nanofury/NanoFury/NF1/kicad/NF1-MCP-V01/NF1-MCP2210-v1.sch

## KiCad design NF1/kicad/NF1-MCP-V01/NF1-MCP2210-v1.sch (2013-09-19, an earlier design)

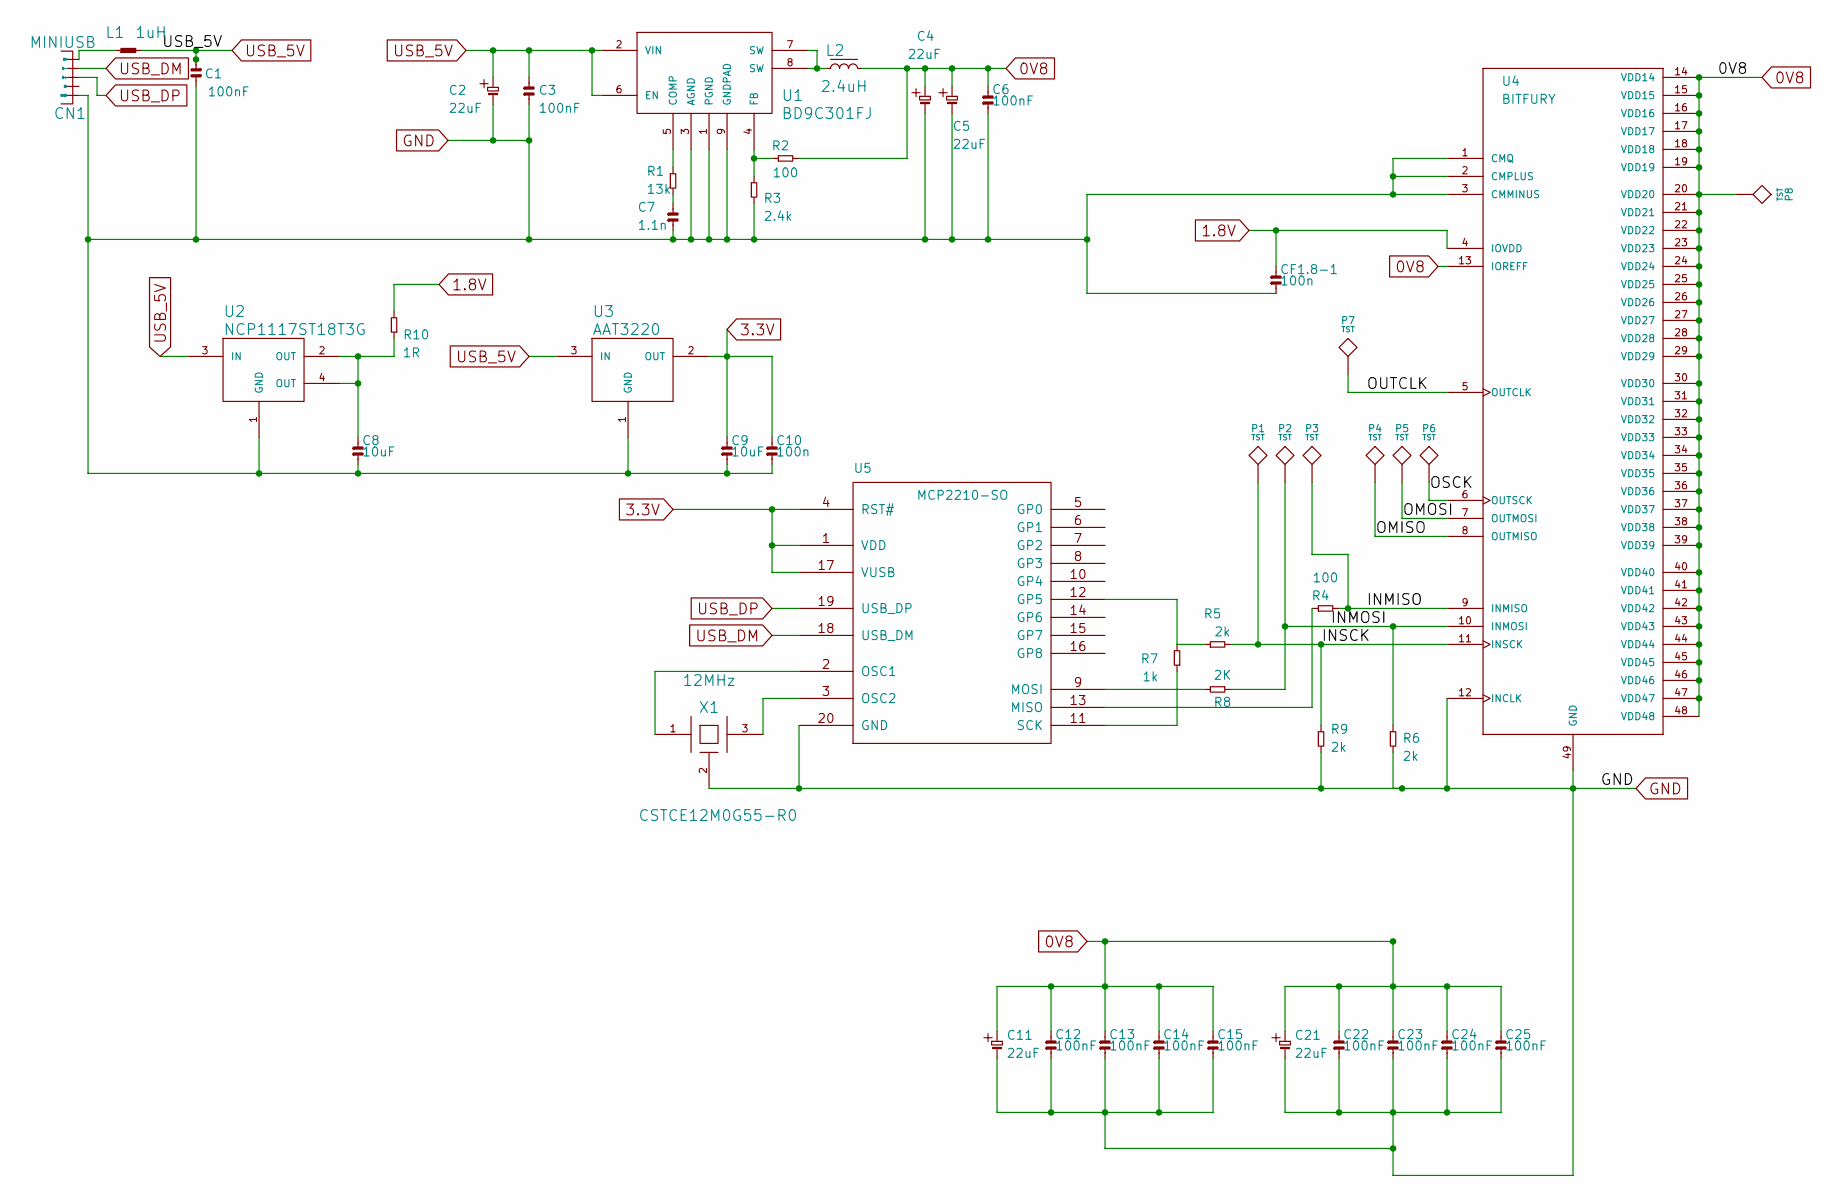
[picture p1: schematic NF1-MCP2210-v1.sch]

Parts:
C1, C3, C6, C12, C13, C14, C15, C22, C23, C24, C25: 100nF; 0402
C2, C4, C5, C11, C21: 22uF; 0805
C7: 1.1n; 0402
C8, C9: 10uF; 0805
C10: 100n; 0402
CF1.8-1: 100n; 0402
CN1: MINIUSB; USBAPCB
L1: 1uH; 0402
L2: 2.4uH; 0630
P1, P2, P3, P4, P5, P6, P7, P8: TST; TP
R1: 13k; 0402
R2, R4: 100; 0402
R3: 2.4k; 0402
R5, R6, R9: 2k; 0402
R7: 1k; 0402
R8: 2K; 0402
R10: 1R; 0402
U1: BD9C301FJ; HTSOP-J8
U2: NCP1117ST18T3G; SOT-223
U3: AAT3220; SC59
U4: BITFURY; QFN48
U5: MCP2210-SO; SSOP-20
X1: 12MHz; CSTCE_G15C; Part Number CSTCE12M0G55-R0

Connections:
0V8: C4.1, C5.1, C6.1, C11.1, C12.1, C13.1, C14.1, C15.1, C21.1, C22.1, C23.1, C24.1, C25.1, L2.2, P8.1, R2.1, U4.13 (IOREFF), U4.14 (VDD14), U4.15 (VDD15), U4.16 (VDD16), U4.17 (VDD17), U4.18 (VDD18), U4.19 (VDD19), U4.20 (VDD20), U4.21 (VDD21), U4.22 (VDD22), U4.23 (VDD23), U4.24 (VDD24), U4.25 (VDD25), U4.26 (VDD26), U4.27 (VDD27), U4.28 (VDD28), U4.29 (VDD29), U4.30 (VDD30), U4.31 (VDD31), U4.32 (VDD32), U4.33 (VDD33), U4.34 (VDD34), U4.35 (VDD35), U4.36 (VDD36), U4.37 (VDD37), U4.38 (VDD38), U4.39 (VDD39), U4.40 (VDD40), U4.41 (VDD41), U4.42 (VDD42), U4.43 (VDD43), U4.44 (VDD44), U4.45 (VDD45), U4.46 (VDD46), U4.47 (VDD47), U4.48 (VDD48)
1.8V: CF1.8-1.1, R10.1, U4.4 (IOVDD)
3.3V: C9.1, C10.1, U3.2 (OUT), U5.1 (VDD), U5.4 (RST#), U5.17 (VUSB)
GND: C1.1, C2.2, C3.2, C4.2, C5.2, C6.2, C7.2, C8.2, C9.2, C10.2, C11.2, C12.2, C13.2, C14.2, C15.2, C21.2, C22.2, C23.2, C24.2, C25.2, CF1.8-1.2, CN1.5 (GND), R3.1, R6.1, R9.1, U1.1 (PGND), U1.3 (AGND), U1.9 (GNDPAD), U2.1 (GND), U3.1 (GND), U4.1 (CMQ), U4.2 (CMPLUS), U4.3 (CMMINUS), U4.12 (INCLK), U4.49 (GND), U5.20 (GND), X1.2 (GND)
INMISO: P3.1, R4.1, U4.9 (INMISO)
INMOSI: P2.1, R6.2, R8.2, U4.10 (INMOSI)
INSCK: P1.1, R5.1, R9.2, U4.11 (INSCK)
unnamed: C7.1, R1.1
unnamed: C8.1, R10.2, U2.2 (OUT), U2.4 (OUT)
unnamed: CN1.1 (5V), L1.1
unnamed: L2.1, U1.7 (SW), U1.8 (SW)
unnamed: R1.2, U1.5 (COMP)
unnamed: R2.2, R3.2, U1.4 (FB)
unnamed: R4.2, U5.13 (MISO)
unnamed: R5.2, R7.1, U5.12 (GP5)
unnamed: R7.2, U5.11 (SCK)
unnamed: R8.1, U5.9 (MOSI)
unnamed: U5.2 (OSC1), X1.1
unnamed: U5.3 (OSC2), X1.3
OMISO: P4.1, U4.8 (OUTMISO)
OMOSI: P5.1, U4.7 (OUTMOSI)
OSCK: P6.1, U4.6 (OUTSCK)
OUTCLK: P7.1, U4.5 (OUTCLK)
USB_5V: C1.2, C2.1, C3.1, L1.2, U1.2 (VIN), U1.6 (EN), U2.3 (IN), U3.3 (IN)
USB_DM: CN1.2 (D-), U5.18 (USB_DM)
USB_DP: CN1.3 (D+), U5.19 (USB_DP)
