nanofury/NanoFury/NF1/kicad/NF6-MCP-V03/NF6-MCP2210-v03.kicad_pcb

## KiCad design NF1/kicad/NF6-MCP-V03/NF6-MCP2210-v03.kicad_pcb (2021-02-23)

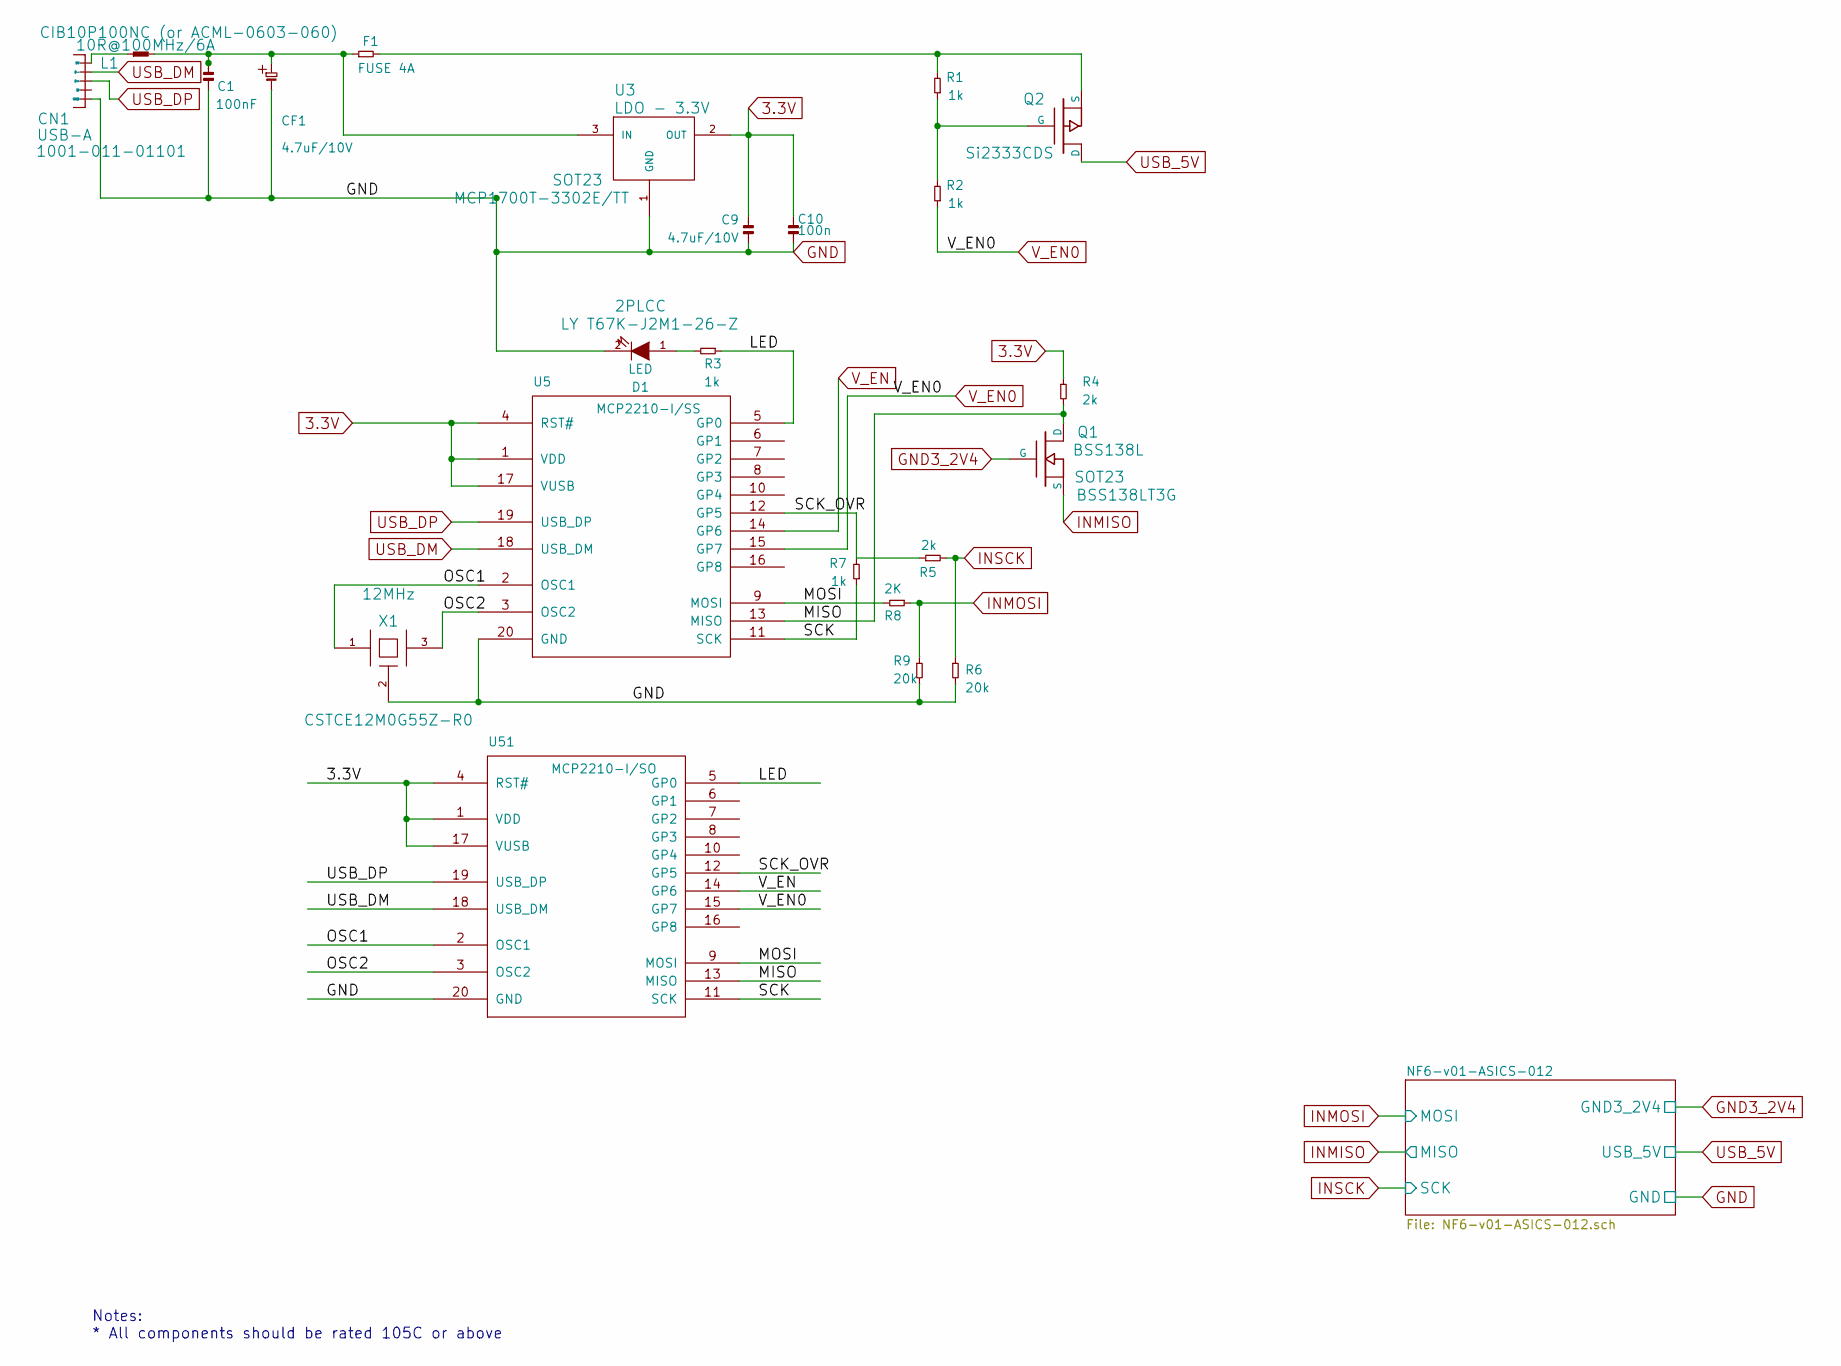
[picture p3: schematic NF6-MCP2210-v03.sch, NanoFury NF6]

Parts:
C1: 100nF; 0603
C9: 4.7uF/10V; 0805
C10: 100n; 0603
CF1: 4.7uF/10V; 0805
CN1: USB-A; CNC-1001-011-01101
D1: LED; 2PLCC
F1: FUSE 4A; 0603
L1: 10R@100MHz/6A; 0603
Q1: BSS138L; SOT23; Manufacturer Part Number BSS138LT3G
Q2: Si2333CDS; SOT23
R1, R2, R3, R7: 1k; 0603
R4: 2k; 0603
R5: 2k; 0805
R6, R9: 20k; 0603
R8: 2K; 0603
U3: LDO - 3.3V; SOT23
U5: MCP2210-I/SS; SSOP-20
U51: MCP2210-I/SO; SOIC20
X1: 12MHz; CSTCE_G15C

Connections:
3.3V: C9.1, C10.1, R4.2, U3.2 (OUT), U5.1 (VDD), U5.4 (RST#), U5.17 (VUSB), U51.1 (VDD), U51.4 (RST#), U51.17 (VUSB)
/LED: R3.2, U5.5 (GP0), U51.5 (GP0)
/MISO: Q1.3 (D), R4.1, U5.13 (MISO), U51.13 (MISO)
/MOSI: R8.1, U5.9 (MOSI), U51.9 (MOSI)
/OSC1: U5.2 (OSC1), U51.2 (OSC1), X1.1
/OSC2: U5.3 (OSC2), U51.3 (OSC2), X1.3
/SCK: R7.2, U5.11 (SCK), U51.11 (SCK)
/SCK_OVR: R5.2, R7.1, U5.12 (GP5), U51.12 (GP5)
GND: C1.1, C9.2, C10.2, CF1.2, CN1.5 (GND), D1.2 (K), R6.1, R9.1, U3.1 (GND), U5.20 (GND), U51.20 (GND), X1.2 (GND); also elsewhere on the board
GND3_2V4: Q1.1 (G); also elsewhere on the board
INMISO: Q1.2 (S); also elsewhere on the board
INMOSI: R8.2, R9.2; also elsewhere on the board
INSCK: R5.1, R6.2; also elsewhere on the board
unnamed: D1.1 (A), R3.1
unnamed: F1.1, Q2.2 (S), R1.1
unnamed: Q2.1 (G), R1.2, R2.1
unnamed: C1.2, CF1.1, F1.2, L1.2, U3.3 (IN)
unnamed: CN1.1 (5V), L1.1
USB_5V: Q2.3 (D); also elsewhere on the board
USB_DM: CN1.2 (D-), U5.18 (USB_DM), U51.18 (USB_DM)
USB_DP: CN1.3 (D+), U5.19 (USB_DP), U51.19 (USB_DP)
V_EN: U5.14 (GP6), U51.14 (GP6)
V_EN0: R2.2, U5.15 (GP7), U51.15 (GP7)

Notes on the sheet:
Notes: * All components should be rated 105C or above

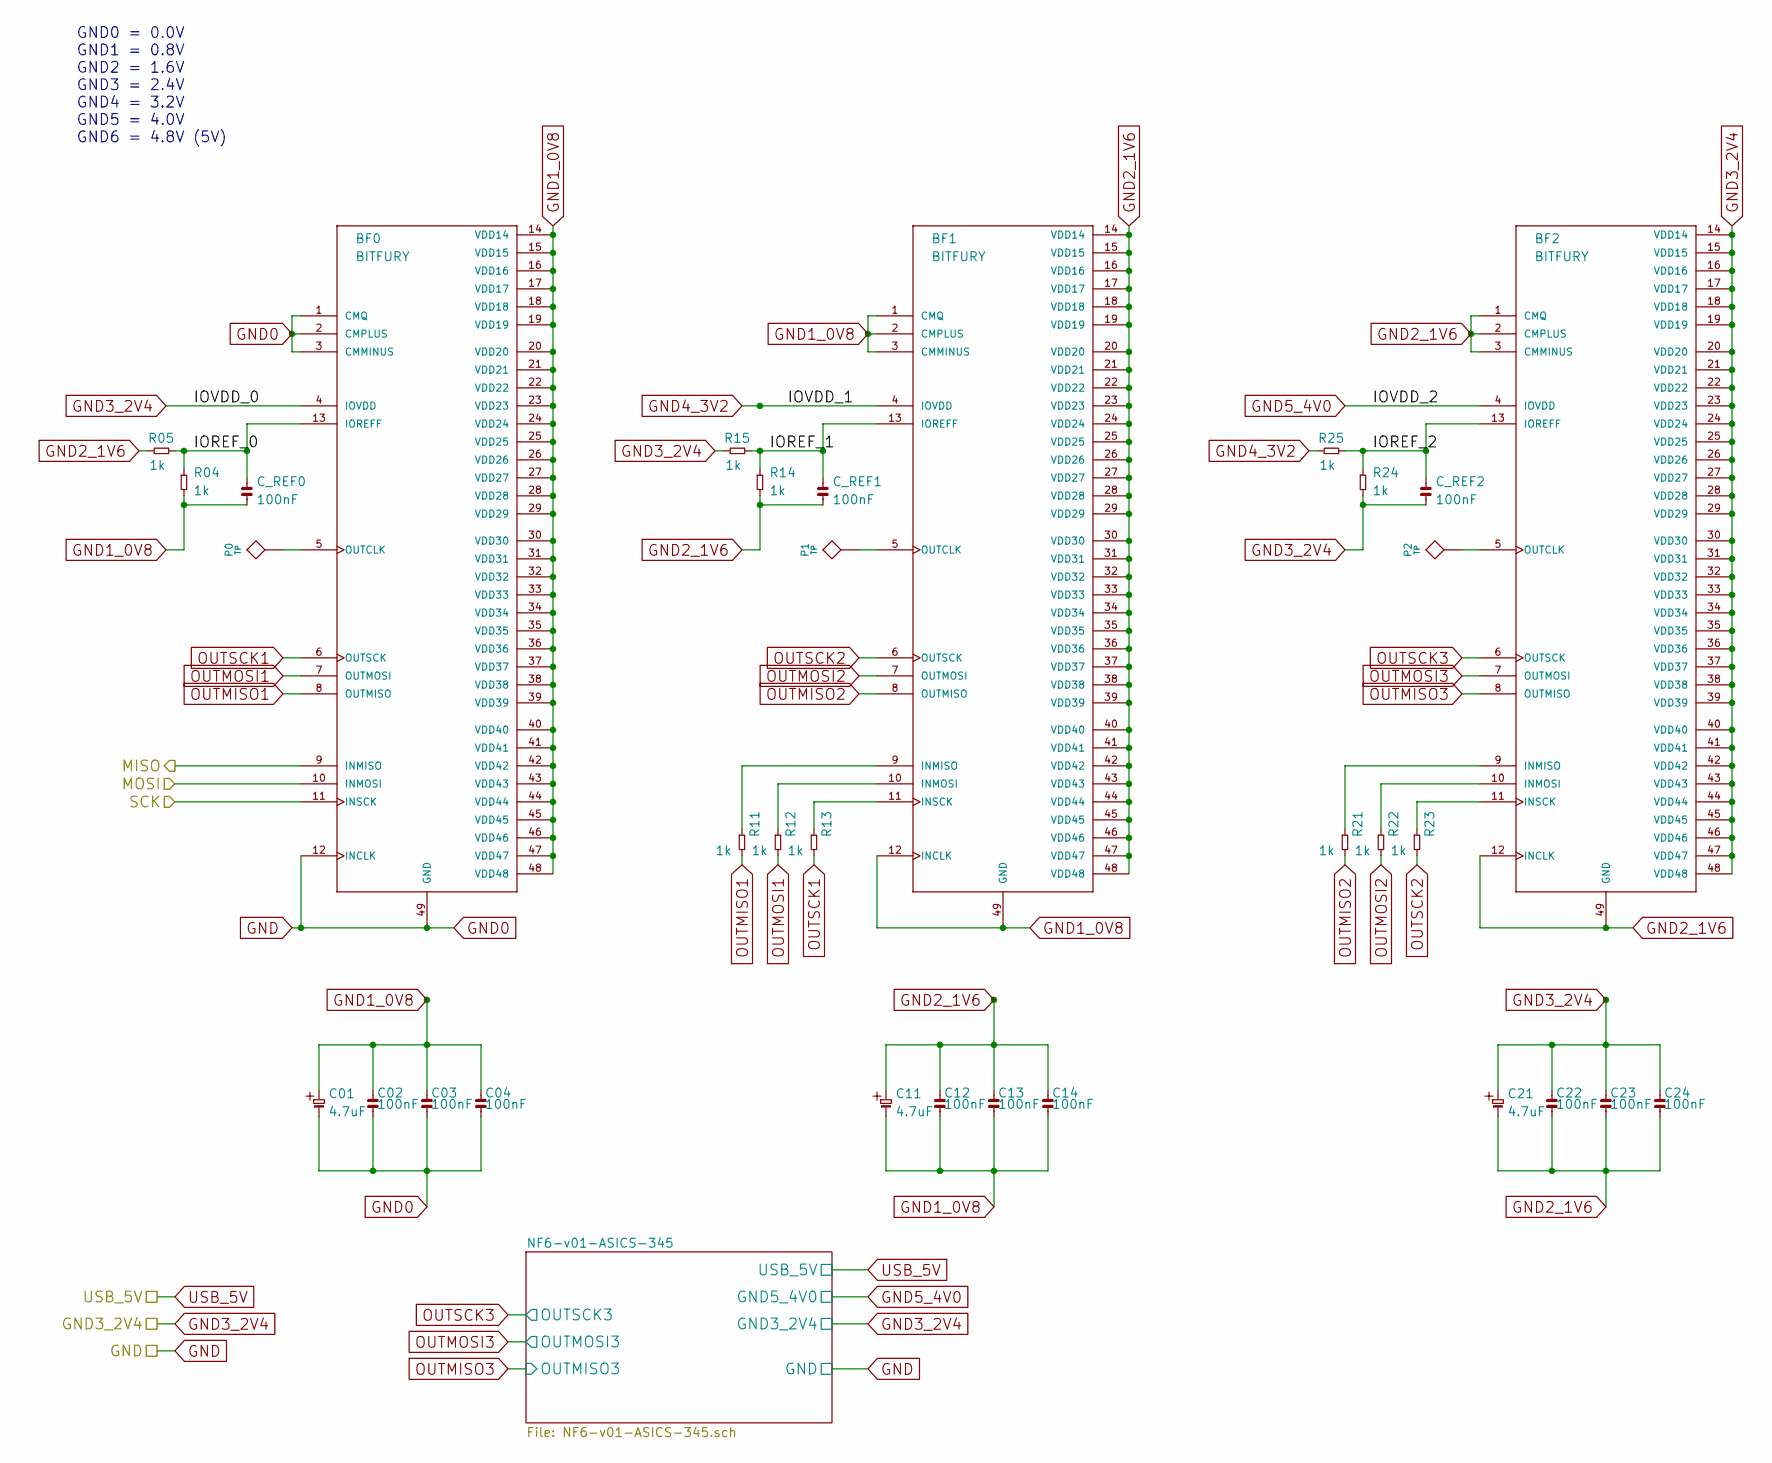
[picture p4: schematic NF6-v01-ASICS-012.sch, NanoFury NF6]

Parts:
BF0, BF1, BF2: BITFURY; QFN48
C01, C11, C21: 4.7uF; 0805
C02, C03, C04, C12, C13, C14, C22, C23, C24: 100nF; 0603
C_REF0, C_REF1, C_REF2: 100nF; 0603
P0, P1, P2: TP
R04, R05, R11, R12, R13, R14, R15, R21, R22, R23, R24, R25: 1k; 0603

Connections:
/NF6-v01-ASICS-012/IOREF_0: BF0.13 (IOREFF), C_REF0.1, R04.2, R05.1
/NF6-v01-ASICS-012/IOREF_1: BF1.13 (IOREFF), C_REF1.1, R14.2, R15.1
/NF6-v01-ASICS-012/IOREF_2: BF2.13 (IOREFF), C_REF2.1, R24.2, R25.1
GND: BF0.1 (CMQ), BF0.2 (CMPLUS), BF0.3 (CMMINUS), BF0.12 (INCLK), BF0.49 (GND), C01.2, C02.2, C03.2, C04.2; also elsewhere on the board
GND1_0V8: BF0.14 (VDD14), BF0.15 (VDD15), BF0.16 (VDD16), BF0.17 (VDD17), BF0.18 (VDD18), BF0.19 (VDD19), BF0.20 (VDD20), BF0.21 (VDD21), BF0.22 (VDD22), BF0.23 (VDD23), BF0.24 (VDD24), BF0.25 (VDD25), BF0.26 (VDD26), BF0.27 (VDD27), BF0.28 (VDD28), BF0.29 (VDD29), BF0.30 (VDD30), BF0.31 (VDD31), BF0.32 (VDD32), BF0.33 (VDD33), BF0.34 (VDD34), BF0.35 (VDD35), BF0.36 (VDD36), BF0.37 (VDD37), BF0.38 (VDD38), BF0.39 (VDD39), BF0.40 (VDD40), BF0.41 (VDD41), BF0.42 (VDD42), BF0.43 (VDD43), BF0.44 (VDD44), BF0.45 (VDD45), BF0.46 (VDD46), BF0.47 (VDD47), BF0.48 (VDD48), BF1.1 (CMQ), BF1.2 (CMPLUS), BF1.3 (CMMINUS), BF1.12 (INCLK), BF1.49 (GND), C01.1, C02.1, C03.1, C04.1, C11.2, C12.2, C13.2, C14.2, C_REF0.2, R04.1
GND2_1V6: BF1.14 (VDD14), BF1.15 (VDD15), BF1.16 (VDD16), BF1.17 (VDD17), BF1.18 (VDD18), BF1.19 (VDD19), BF1.20 (VDD20), BF1.21 (VDD21), BF1.22 (VDD22), BF1.23 (VDD23), BF1.24 (VDD24), BF1.25 (VDD25), BF1.26 (VDD26), BF1.27 (VDD27), BF1.28 (VDD28), BF1.29 (VDD29), BF1.30 (VDD30), BF1.31 (VDD31), BF1.32 (VDD32), BF1.33 (VDD33), BF1.34 (VDD34), BF1.35 (VDD35), BF1.36 (VDD36), BF1.37 (VDD37), BF1.38 (VDD38), BF1.39 (VDD39), BF1.40 (VDD40), BF1.41 (VDD41), BF1.42 (VDD42), BF1.43 (VDD43), BF1.44 (VDD44), BF1.45 (VDD45), BF1.46 (VDD46), BF1.47 (VDD47), BF1.48 (VDD48), BF2.1 (CMQ), BF2.2 (CMPLUS), BF2.3 (CMMINUS), BF2.12 (INCLK), BF2.49 (GND), C11.1, C12.1, C13.1, C14.1, C21.2, C22.2, C23.2, C24.2, C_REF1.2, R05.2, R14.1
GND3_2V4: BF0.4 (IOVDD), BF2.14 (VDD14), BF2.15 (VDD15), BF2.16 (VDD16), BF2.17 (VDD17), BF2.18 (VDD18), BF2.19 (VDD19), BF2.20 (VDD20), BF2.21 (VDD21), BF2.22 (VDD22), BF2.23 (VDD23), BF2.24 (VDD24), BF2.25 (VDD25), BF2.26 (VDD26), BF2.27 (VDD27), BF2.28 (VDD28), BF2.29 (VDD29), BF2.30 (VDD30), BF2.31 (VDD31), BF2.32 (VDD32), BF2.33 (VDD33), BF2.34 (VDD34), BF2.35 (VDD35), BF2.36 (VDD36), BF2.37 (VDD37), BF2.38 (VDD38), BF2.39 (VDD39), BF2.40 (VDD40), BF2.41 (VDD41), BF2.42 (VDD42), BF2.43 (VDD43), BF2.44 (VDD44), BF2.45 (VDD45), BF2.46 (VDD46), BF2.47 (VDD47), BF2.48 (VDD48), C21.1, C22.1, C23.1, C24.1, C_REF2.2, R15.2, R24.1; also elsewhere on the board
GND4_3V2: BF1.4 (IOVDD), R25.2; also elsewhere on the board
GND5_4V0: BF2.4 (IOVDD); also elsewhere on the board
INMISO: BF0.9 (INMISO); also elsewhere on the board
INMOSI: BF0.10 (INMOSI); also elsewhere on the board
INSCK: BF0.11 (INSCK); also elsewhere on the board
unnamed: BF2.9 (INMISO), R21.2
unnamed: BF2.10 (INMOSI), R22.2
unnamed: BF2.11 (INSCK), R23.2
unnamed: BF2.5 (OUTCLK), P2.1
unnamed: BF1.5 (OUTCLK), P1.1
unnamed: BF0.5 (OUTCLK), P0.1
unnamed: BF1.9 (INMISO), R11.2
unnamed: BF1.10 (INMOSI), R12.2
unnamed: BF1.11 (INSCK), R13.2
OUTMISO1: BF0.8 (OUTMISO), R11.1
OUTMISO2: BF1.8 (OUTMISO), R21.1
OUTMISO3: BF2.8 (OUTMISO); also elsewhere on the board
OUTMOSI1: BF0.7 (OUTMOSI), R12.1
OUTMOSI2: BF1.7 (OUTMOSI), R22.1
OUTMOSI3: BF2.7 (OUTMOSI); also elsewhere on the board
OUTSCK1: BF0.6 (OUTSCK), R13.1
OUTSCK2: BF1.6 (OUTSCK), R23.1
OUTSCK3: BF2.6 (OUTSCK); also elsewhere on the board

Notes on the sheet:
GND0 = 0.0V GND1 = 0.8V GND2 = 1.6V GND3 = 2.4V GND4 = 3.2V GND5 = 4.0V GND6 = 4.8V (5V)

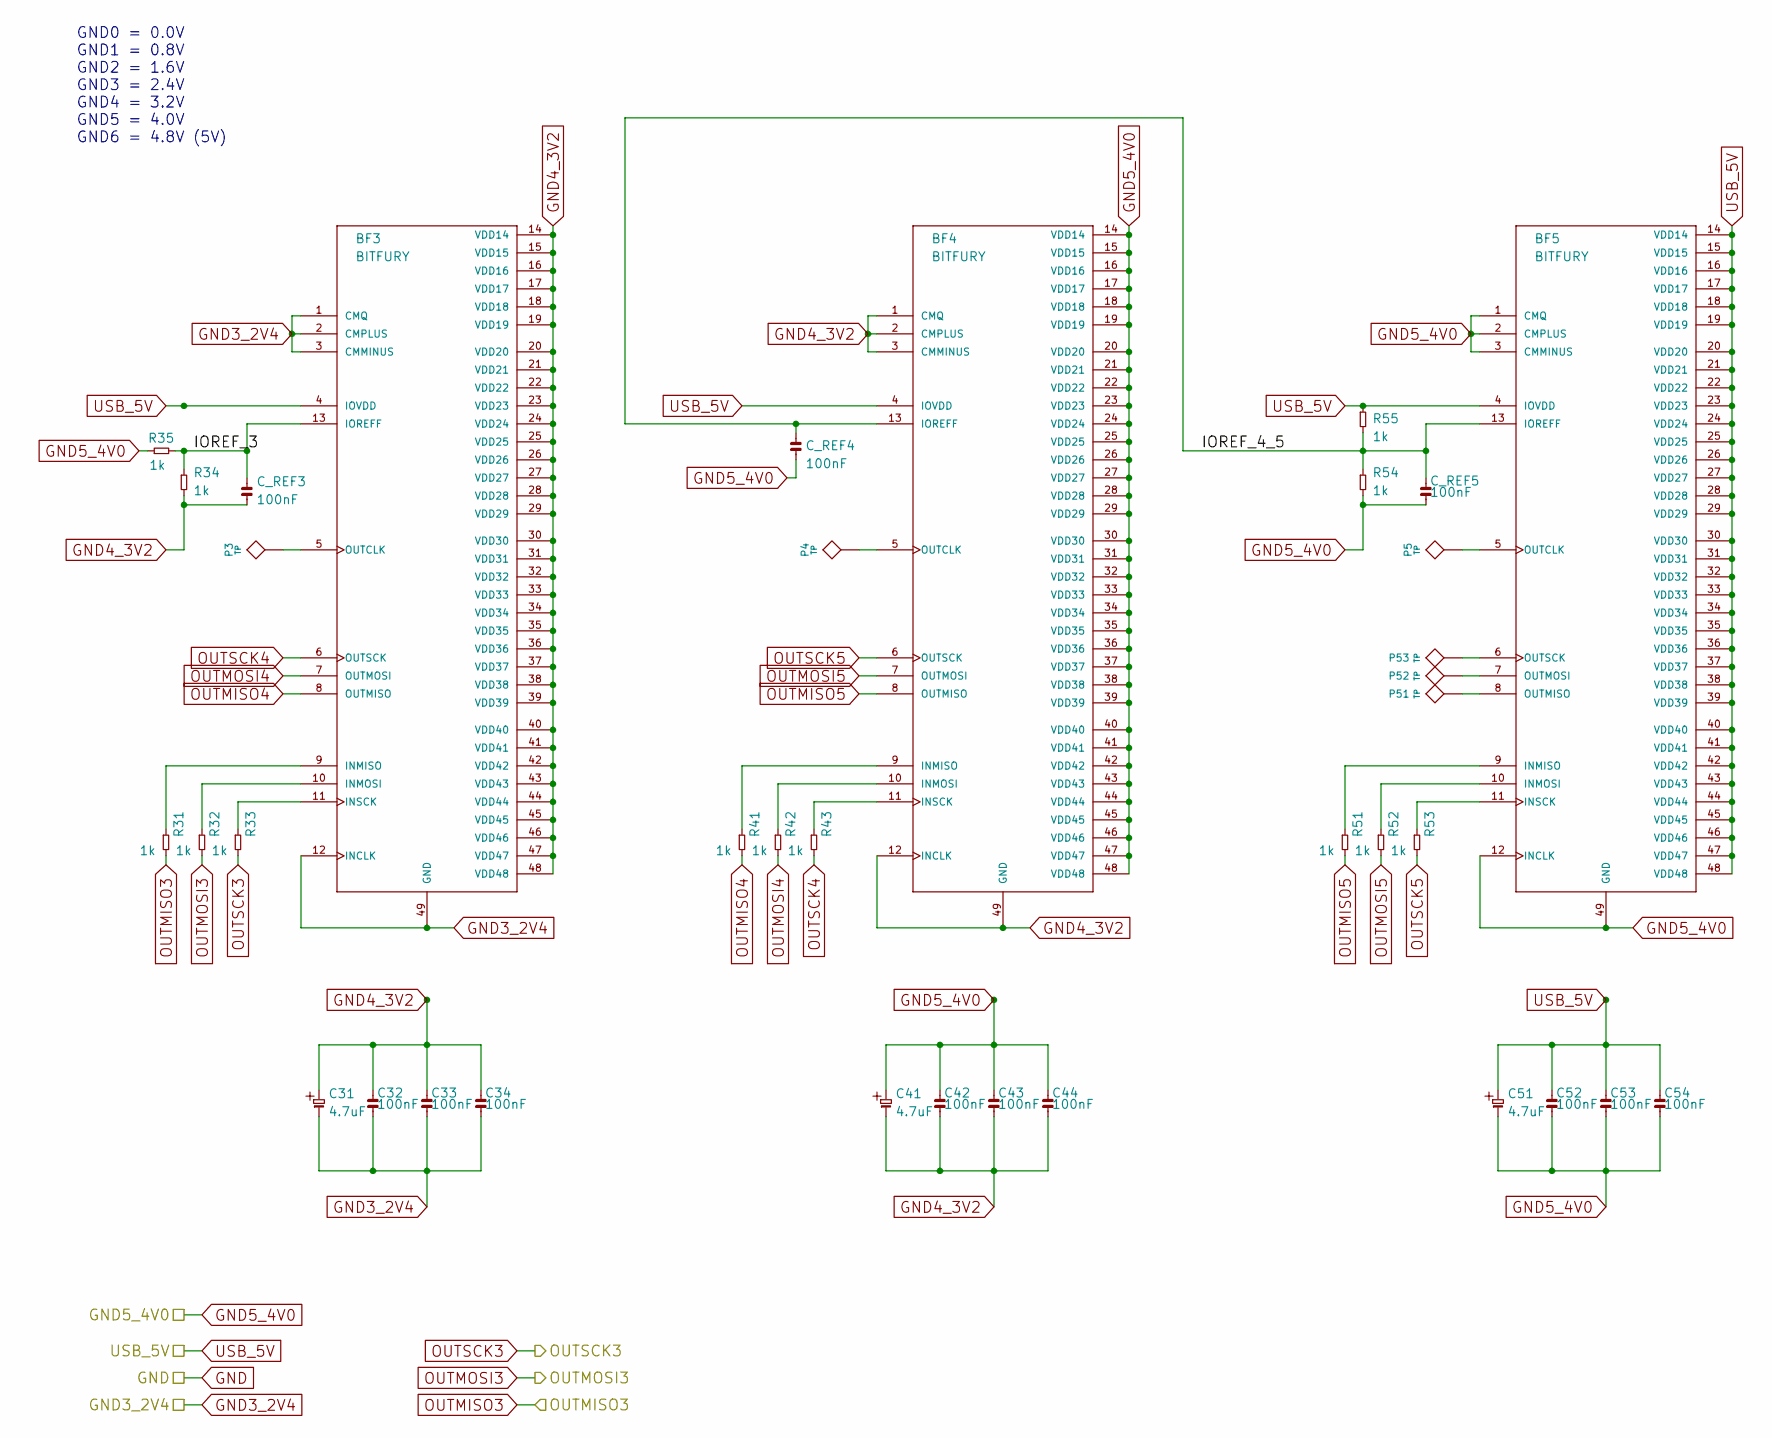
[picture p5: schematic NF6-v01-ASICS-345.sch, NanoFury NF6]

Parts:
BF3, BF4, BF5: BITFURY; QFN48
C31, C41, C51: 4.7uF; 0805
C32, C33, C34, C42, C43, C44, C52, C53, C54: 100nF; 0603
C_REF3, C_REF4, C_REF5: 100nF; 0603
P3, P4, P5, P51, P52, P53: TP
R31, R32, R33, R34, R35, R41, R42, R43, R51, R52, R53, R54, R55: 1k; 0603

Connections:
/NF6-v01-ASICS-012/NF6-v01-ASICS-345/IOREF_3: BF3.13 (IOREFF), C_REF3.1, R34.2, R35.1
/NF6-v01-ASICS-012/NF6-v01-ASICS-345/IOREF_4_5: BF4.13 (IOREFF), BF5.13 (IOREFF), C_REF4.1, C_REF5.1, R54.2, R55.1
GND3_2V4: BF3.1 (CMQ), BF3.2 (CMPLUS), BF3.3 (CMMINUS), BF3.12 (INCLK), BF3.49 (GND), C31.2, C32.2, C33.2, C34.2; also elsewhere on the board
GND4_3V2: BF3.14 (VDD14), BF3.15 (VDD15), BF3.16 (VDD16), BF3.17 (VDD17), BF3.18 (VDD18), BF3.19 (VDD19), BF3.20 (VDD20), BF3.21 (VDD21), BF3.22 (VDD22), BF3.23 (VDD23), BF3.24 (VDD24), BF3.25 (VDD25), BF3.26 (VDD26), BF3.27 (VDD27), BF3.28 (VDD28), BF3.29 (VDD29), BF3.30 (VDD30), BF3.31 (VDD31), BF3.32 (VDD32), BF3.33 (VDD33), BF3.34 (VDD34), BF3.35 (VDD35), BF3.36 (VDD36), BF3.37 (VDD37), BF3.38 (VDD38), BF3.39 (VDD39), BF3.40 (VDD40), BF3.41 (VDD41), BF3.42 (VDD42), BF3.43 (VDD43), BF3.44 (VDD44), BF3.45 (VDD45), BF3.46 (VDD46), BF3.47 (VDD47), BF3.48 (VDD48), BF4.1 (CMQ), BF4.2 (CMPLUS), BF4.3 (CMMINUS), BF4.12 (INCLK), BF4.49 (GND), C31.1, C32.1, C33.1, C34.1, C41.2, C42.2, C43.2, C44.2, C_REF3.2, R34.1; also elsewhere on the board
GND5_4V0: BF4.14 (VDD14), BF4.15 (VDD15), BF4.16 (VDD16), BF4.17 (VDD17), BF4.18 (VDD18), BF4.19 (VDD19), BF4.20 (VDD20), BF4.21 (VDD21), BF4.22 (VDD22), BF4.23 (VDD23), BF4.24 (VDD24), BF4.25 (VDD25), BF4.26 (VDD26), BF4.27 (VDD27), BF4.28 (VDD28), BF4.29 (VDD29), BF4.30 (VDD30), BF4.31 (VDD31), BF4.32 (VDD32), BF4.33 (VDD33), BF4.34 (VDD34), BF4.35 (VDD35), BF4.36 (VDD36), BF4.37 (VDD37), BF4.38 (VDD38), BF4.39 (VDD39), BF4.40 (VDD40), BF4.41 (VDD41), BF4.42 (VDD42), BF4.43 (VDD43), BF4.44 (VDD44), BF4.45 (VDD45), BF4.46 (VDD46), BF4.47 (VDD47), BF4.48 (VDD48), BF5.1 (CMQ), BF5.2 (CMPLUS), BF5.3 (CMMINUS), BF5.12 (INCLK), BF5.49 (GND), C41.1, C42.1, C43.1, C44.1, C51.2, C52.2, C53.2, C54.2, C_REF4.2, C_REF5.2, R35.2, R54.1; also elsewhere on the board
unnamed: BF5.11 (INSCK), R53.2
unnamed: BF5.6 (OUTSCK), P53.1
unnamed: BF5.7 (OUTMOSI), P52.1
unnamed: BF5.8 (OUTMISO), P51.1
unnamed: BF5.9 (INMISO), R51.2
unnamed: BF5.10 (INMOSI), R52.2
unnamed: BF5.5 (OUTCLK), P5.1
unnamed: BF3.9 (INMISO), R31.2
unnamed: BF3.10 (INMOSI), R32.2
unnamed: BF3.11 (INSCK), R33.2
unnamed: BF4.5 (OUTCLK), P4.1
unnamed: BF3.5 (OUTCLK), P3.1
unnamed: BF4.9 (INMISO), R41.2
unnamed: BF4.10 (INMOSI), R42.2
unnamed: BF4.11 (INSCK), R43.2
OUTMISO3: R31.1; also elsewhere on the board
OUTMISO4: BF3.8 (OUTMISO), R41.1
OUTMISO5: BF4.8 (OUTMISO), R51.1
OUTMOSI3: R32.1; also elsewhere on the board
OUTMOSI4: BF3.7 (OUTMOSI), R42.1
OUTMOSI5: BF4.7 (OUTMOSI), R52.1
OUTSCK3: R33.1; also elsewhere on the board
OUTSCK4: BF3.6 (OUTSCK), R43.1
OUTSCK5: BF4.6 (OUTSCK), R53.1
USB_5V: BF3.4 (IOVDD), BF4.4 (IOVDD), BF5.4 (IOVDD), BF5.14 (VDD14), BF5.15 (VDD15), BF5.16 (VDD16), BF5.17 (VDD17), BF5.18 (VDD18), BF5.19 (VDD19), BF5.20 (VDD20), BF5.21 (VDD21), BF5.22 (VDD22), BF5.23 (VDD23), BF5.24 (VDD24), BF5.25 (VDD25), BF5.26 (VDD26), BF5.27 (VDD27), BF5.28 (VDD28), BF5.29 (VDD29), BF5.30 (VDD30), BF5.31 (VDD31), BF5.32 (VDD32), BF5.33 (VDD33), BF5.34 (VDD34), BF5.35 (VDD35), BF5.36 (VDD36), BF5.37 (VDD37), BF5.38 (VDD38), BF5.39 (VDD39), BF5.40 (VDD40), BF5.41 (VDD41), BF5.42 (VDD42), BF5.43 (VDD43), BF5.44 (VDD44), BF5.45 (VDD45), BF5.46 (VDD46), BF5.47 (VDD47), BF5.48 (VDD48), C51.1, C52.1, C53.1, C54.1, R55.2; also elsewhere on the board

Notes on the sheet:
GND0 = 0.0V GND1 = 0.8V GND2 = 1.6V GND3 = 2.4V GND4 = 3.2V GND5 = 4.0V GND6 = 4.8V (5V)

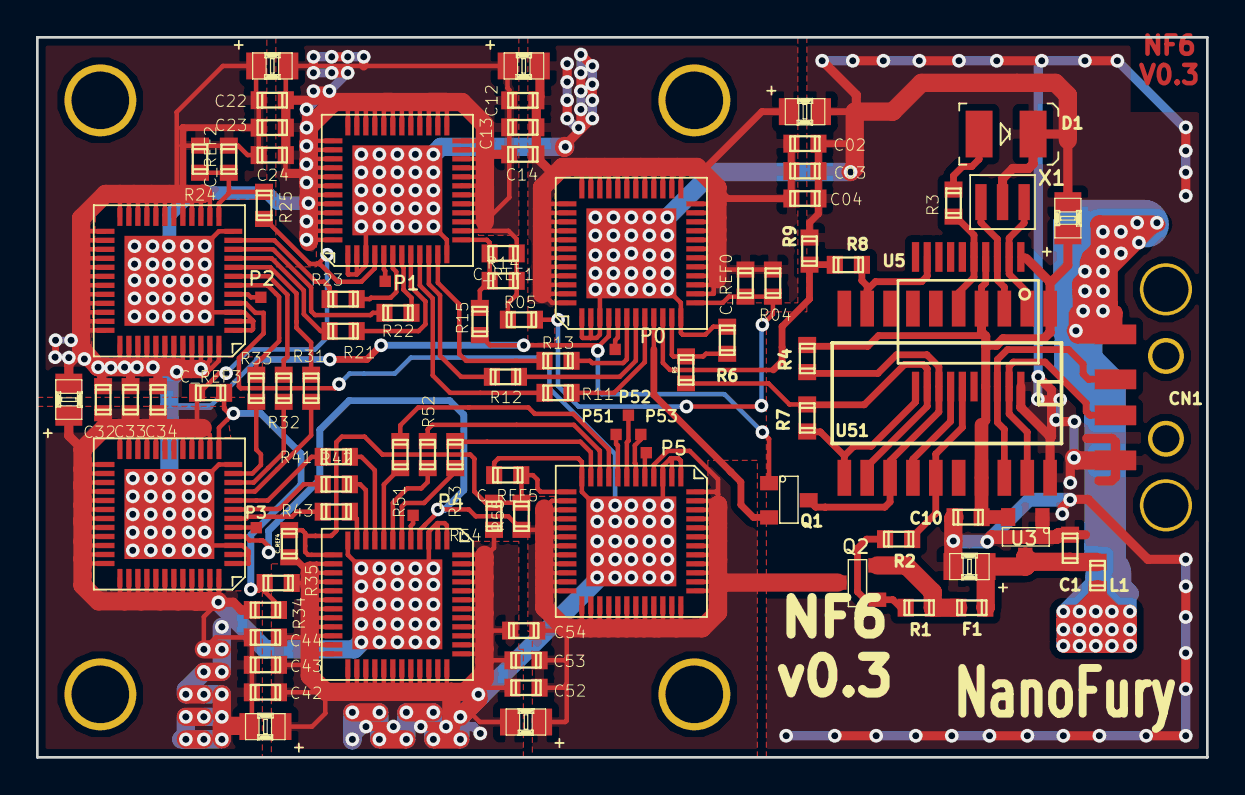
[picture p6: board NF6-MCP2210-v03.kicad_pcb from above]

Board: 2 copper layers, 65.0 x 40.0 mm, 95 parts (0 on the bottom side), 71 nets.

Other parts of the board:
HEATSINK_LCBH40_40x40: VAL**; HEATSINK_LCBH40_40x40
HEATSINK_LCBM40_40x40: VAL**; HEATSINK_LCBM40_40x40
