nanofury/NanoFury/NF1/kicad/NF1-V0.0/NF1.kicad_pcb

## KiCad design NF1/kicad/NF1-V0.0/NF1.kicad_pcb (2013-09-19)

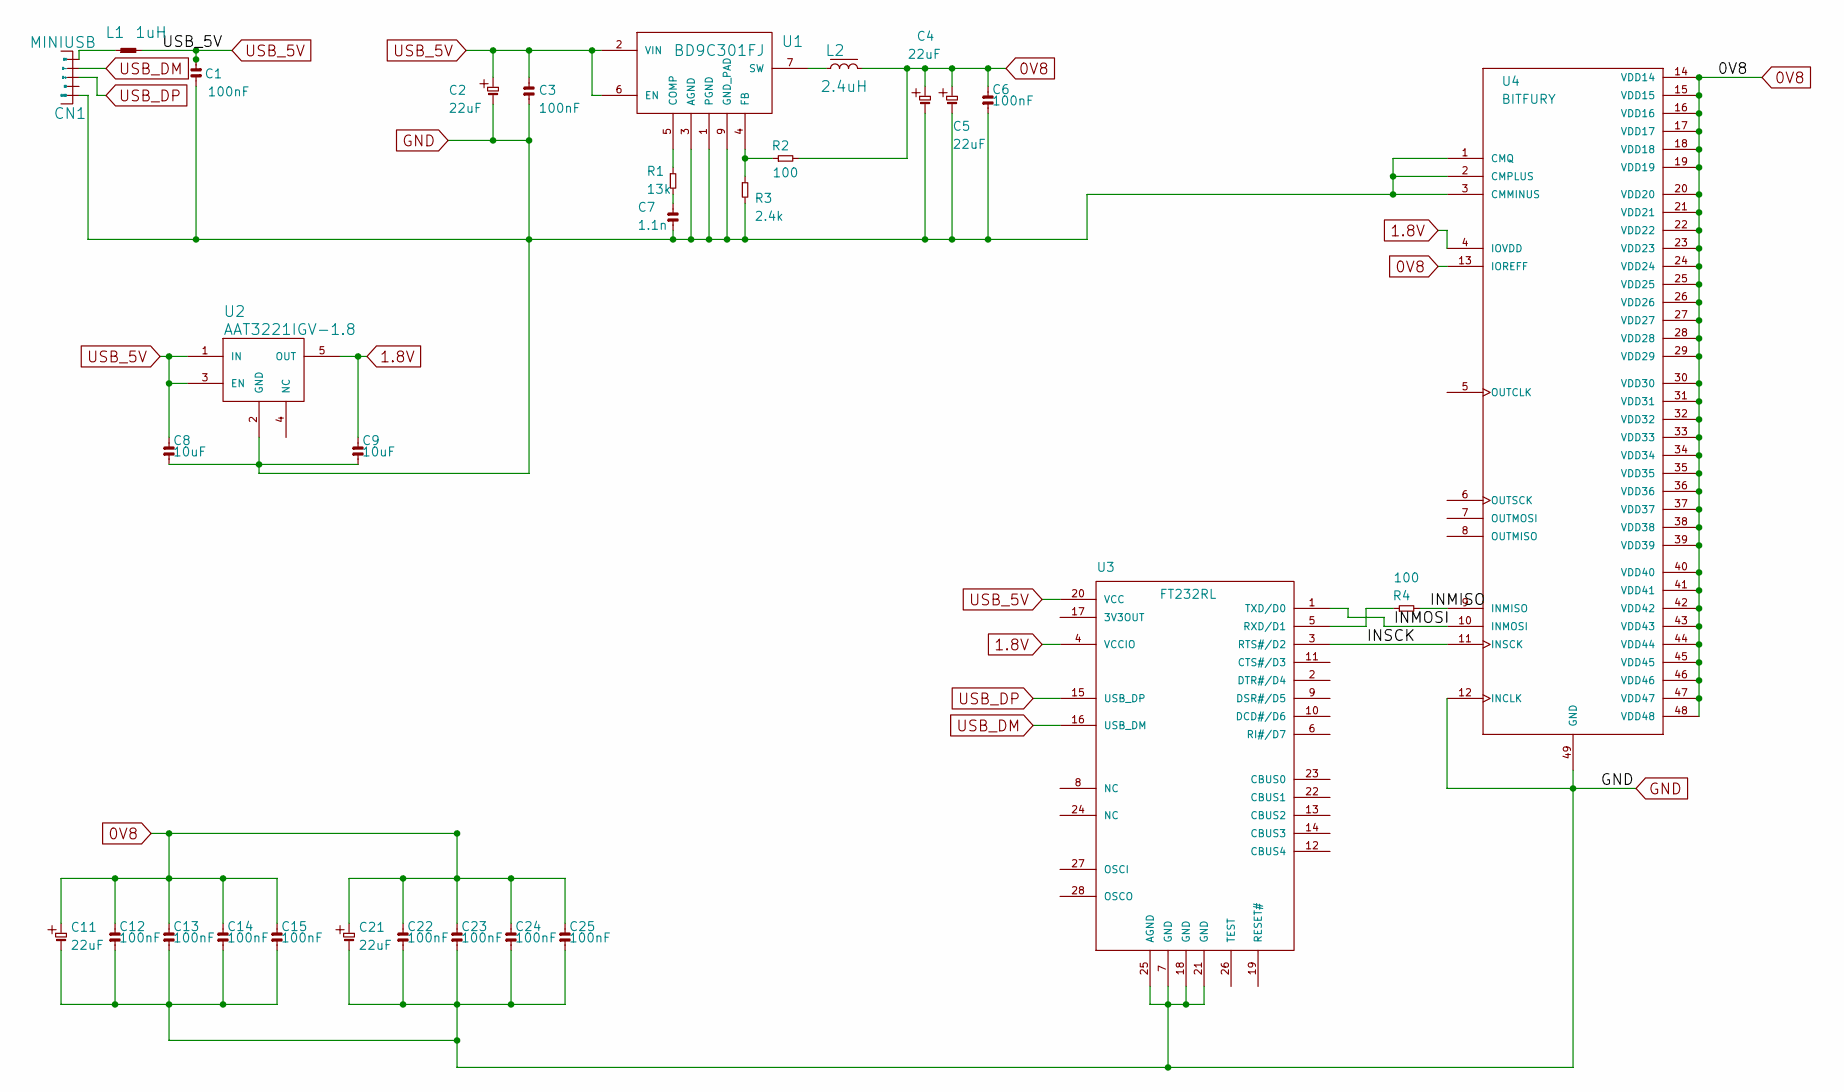
[picture p9: schematic NF1.sch]

Parts:
C1, C3, C6, C12, C13, C14, C15, C22, C23, C24, C25: 100nF; 0402
C2, C4, C5, C11, C21: 22uF; 0805
C7: 1.1n; 0402
C8, C9: 10uF; 0805
CN1: MINIUSB; USBAPCB
L1: 1uH; 0402
L2: 2.4uH; 0630
R1: 13k; 0402
R2, R4: 100; 0402
R3: 2.4k; 0402
U1: BD9C301FJ; HTSOP-J8
U2: AAT3221IGV-1.8; SOT23-5
U3: FT232RL; SSOP28
U4: BITFURY; QFN48

Connections:
0V8: C4.1, C5.1, C6.1, C11.1, C12.1, C13.1, C14.1, C15.1, C21.1, C22.1, C23.1, C24.1, C25.1, L2.2, R2.1, U4.13 (IOREFF), U4.14 (VDD14), U4.15 (VDD15), U4.16 (VDD16), U4.17 (VDD17), U4.18 (VDD18), U4.19 (VDD19), U4.20 (VDD20), U4.21 (VDD21), U4.22 (VDD22), U4.23 (VDD23), U4.24 (VDD24), U4.25 (VDD25), U4.26 (VDD26), U4.27 (VDD27), U4.28 (VDD28), U4.29 (VDD29), U4.30 (VDD30), U4.31 (VDD31), U4.32 (VDD32), U4.33 (VDD33), U4.34 (VDD34), U4.35 (VDD35), U4.36 (VDD36), U4.37 (VDD37), U4.38 (VDD38), U4.39 (VDD39), U4.40 (VDD40), U4.41 (VDD41), U4.42 (VDD42), U4.43 (VDD43), U4.44 (VDD44), U4.45 (VDD45), U4.46 (VDD46), U4.47 (VDD47), U4.48 (VDD48)
1.8V: C9.1, U2.5 (OUT), U3.4 (VCCIO), U4.4 (IOVDD)
/INMISO: R4.1, U4.9 (INMISO)
/INMOSI: U3.1 (TXD/D0), U4.10 (INMOSI)
/INSCK: U3.3 (RTS#/D2), U4.11 (INSCK)
GND: C1.1, C2.2, C3.2, C4.2, C5.2, C6.2, C7.2, C8.2, C9.2, C11.2, C12.2, C13.2, C14.2, C15.2, C21.2, C22.2, C23.2, C24.2, C25.2, CN1.5 (GND), R3.1, U1.1 (PGND), U1.3 (AGND), U1.9 (GND_PAD), U2.2 (GND), U3.7 (GND), U3.18 (GND), U3.21 (GND), U3.25 (AGND), U4.1 (CMQ), U4.2 (CMPLUS), U4.3 (CMMINUS), U4.12 (INCLK), U4.49 (GND)
unnamed: R2.2, R3.2, U1.4 (FB)
unnamed: C7.1, R1.1
unnamed: R1.2, U1.5 (COMP)
unnamed: R4.2, U3.5 (RXD/D1)
unnamed: L2.1, U1.7 (SW)
unnamed: CN1.1 (5V), L1.1
USB_5V: C1.2, C2.1, C3.1, C8.1, L1.2, U1.2 (VIN), U1.6 (EN), U2.1 (IN), U2.3 (EN), U3.20 (VCC)
USB_DM: CN1.2 (D-), U3.16 (USB_DM)
USB_DP: CN1.3 (D+), U3.15 (USB_DP)

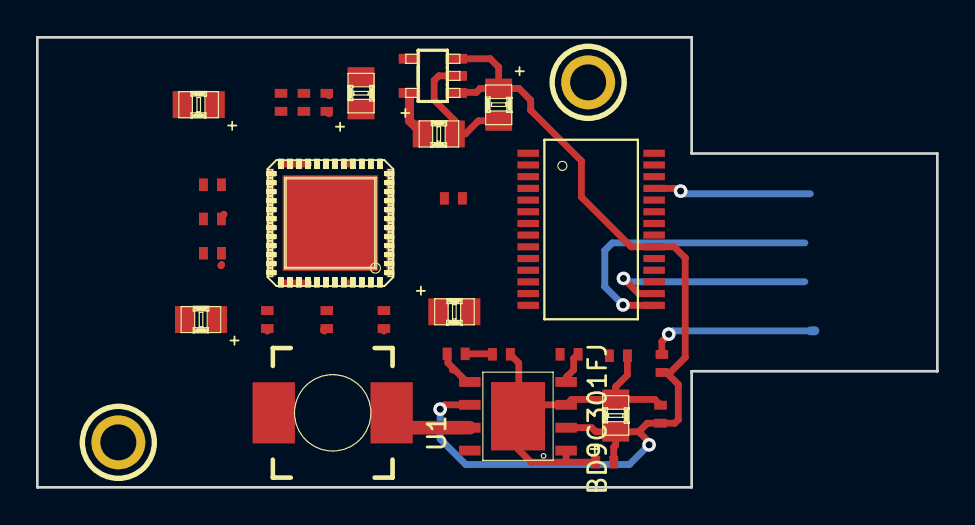
[picture p10: board NF1.kicad_pcb from above]

Board: 2 copper layers, 50.0 x 25.0 mm, 32 parts (1 on the bottom side), 15 nets.

Other parts of the board:
Hole2mm, Hole2mm1: P***; Hole2mm
