nanofury/NanoFury/NF1/kicad/NF2-MCP-V01/NF2-MCP2210-v01.sch

## KiCad design NF1/kicad/NF2-MCP-V01/NF2-MCP2210-v01.sch (2021-02-23, an earlier design)

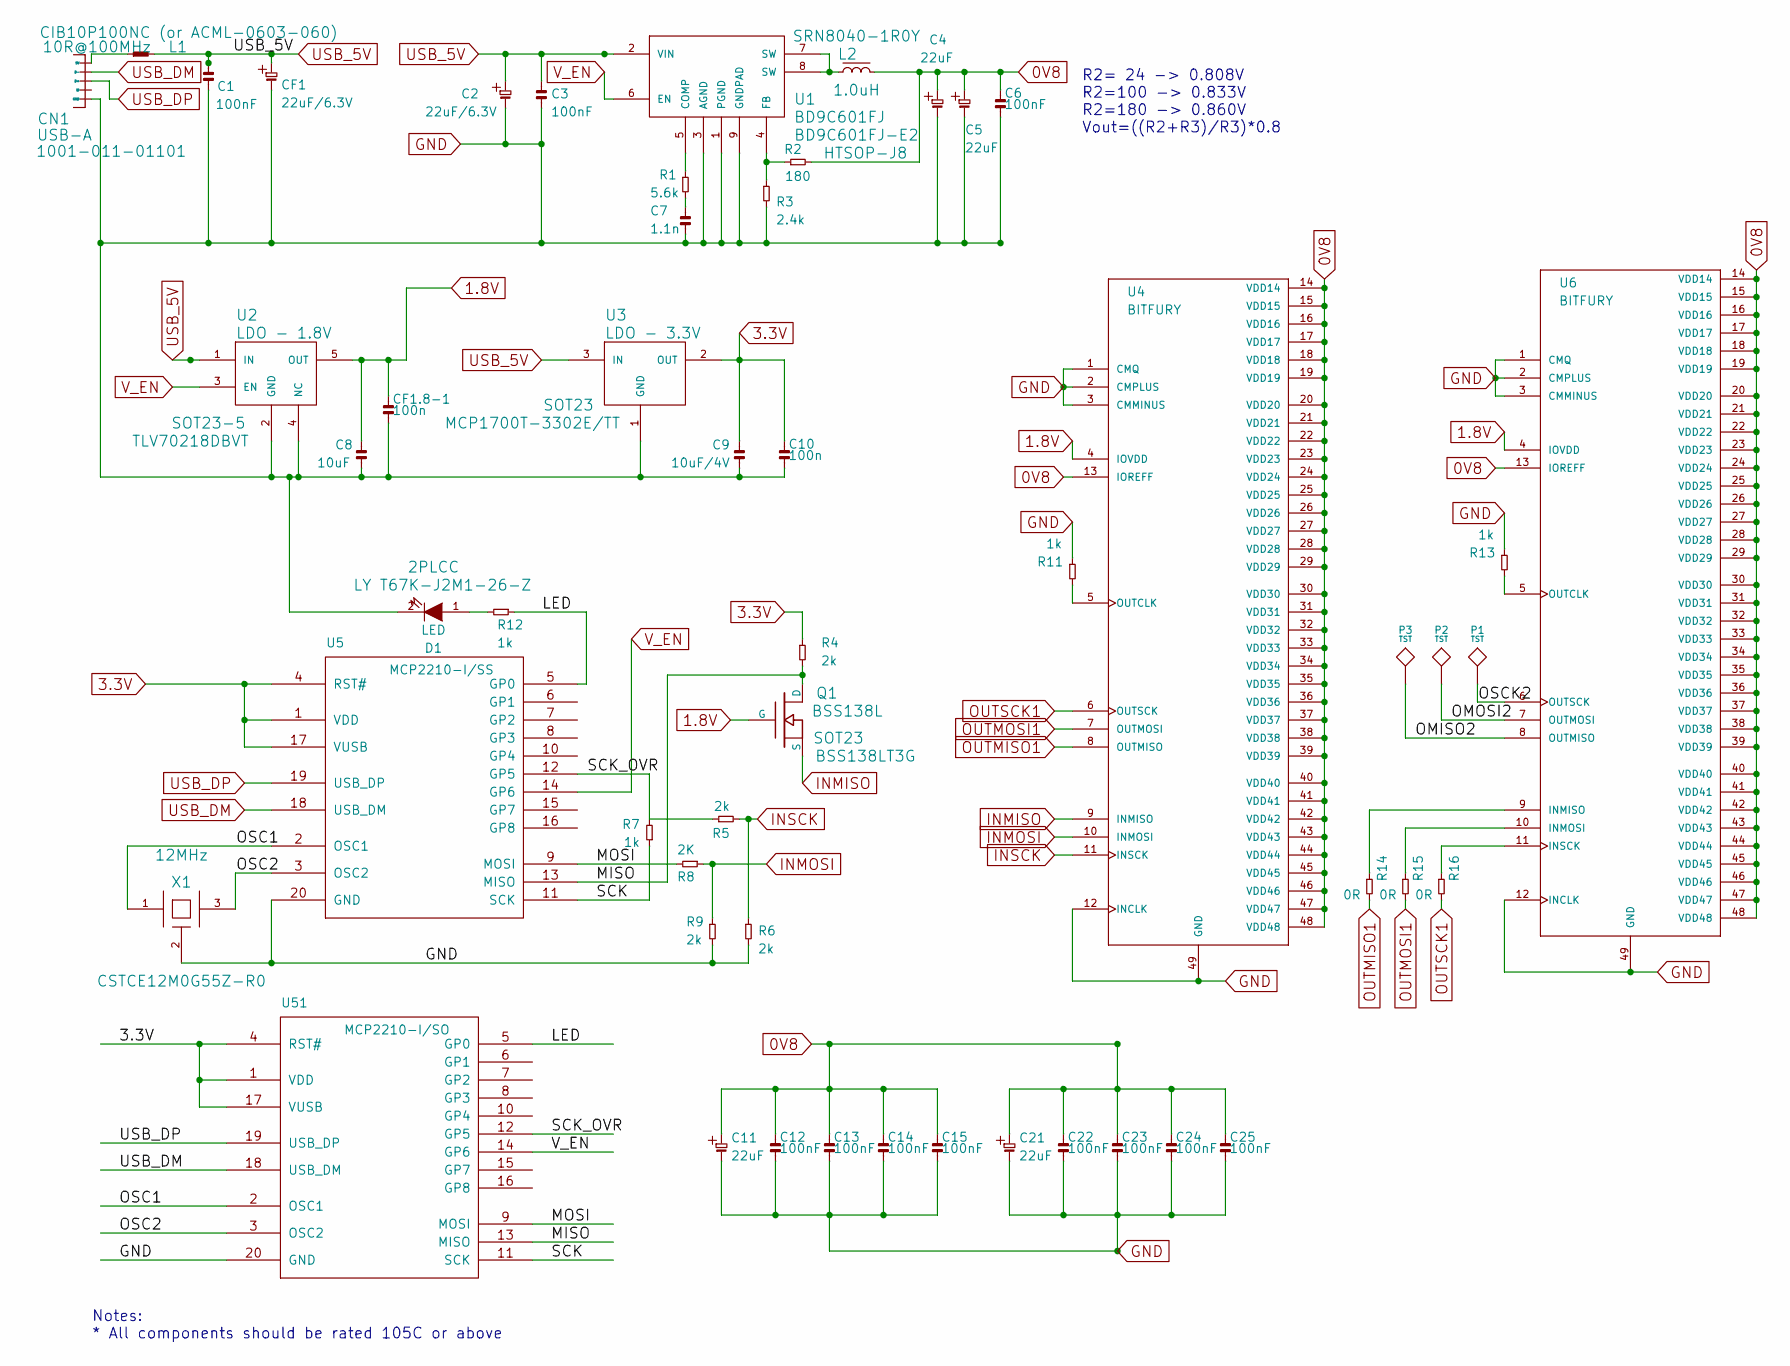
[picture p5: schematic NF2-MCP2210-v01.sch]

Parts:
C1, C3, C6, C12, C13, C14, C15, C22, C23, C24, C25: 100nF; 0603
C2: 22uF/6.3V; 0805
C4, C5, C11, C21: 22uF; 0805
C7: 1.1n; 0603
C8: 10uF; 0805
C9: 10uF/4V; 0805
C10: 100n; 0603
CF1: 22uF/6.3V; 0805
CF1.8-1: 100n; 0603
CN1: USB-A; CNC-1001-011-01101
D1: LED; 2PLCC
L1: 10R@100MHz; 0603
L2: 1.0uH; SRN8040
P1, P2, P3: TST; TP
Q1: BSS138L; SOT23; Manufacturer Part Number BSS138LT3G
R1: 5.6k; 0603
R2: 180; 0805
R3: 2.4k; 0603
R4, R6, R9: 2k; 0603
R5: 2k; 0805
R7, R11, R12, R13: 1k; 0603
R8: 2K; 0603
R14, R15, R16: 0R; 0603
U1: BD9C601FJ; HTSOP-J8
U2: LDO - 1.8V; SOT23-5
U3: LDO - 3.3V; SOT23
U4, U6: BITFURY; QFN48
U5: MCP2210-I/SS; SSOP-20
U51: MCP2210-I/SO; SOIC20
X1: 12MHz; CSTCE_G15C

Connections:
0V8: C4.1, C5.1, C6.1, C11.1, C12.1, C13.1, C14.1, C15.1, C21.1, C22.1, C23.1, C24.1, C25.1, L2.2, R2.1, U4.13 (IOREFF), U4.14 (VDD14), U4.15 (VDD15), U4.16 (VDD16), U4.17 (VDD17), U4.18 (VDD18), U4.19 (VDD19), U4.20 (VDD20), U4.21 (VDD21), U4.22 (VDD22), U4.23 (VDD23), U4.24 (VDD24), U4.25 (VDD25), U4.26 (VDD26), U4.27 (VDD27), U4.28 (VDD28), U4.29 (VDD29), U4.30 (VDD30), U4.31 (VDD31), U4.32 (VDD32), U4.33 (VDD33), U4.34 (VDD34), U4.35 (VDD35), U4.36 (VDD36), U4.37 (VDD37), U4.38 (VDD38), U4.39 (VDD39), U4.40 (VDD40), U4.41 (VDD41), U4.42 (VDD42), U4.43 (VDD43), U4.44 (VDD44), U4.45 (VDD45), U4.46 (VDD46), U4.47 (VDD47), U4.48 (VDD48), U6.13 (IOREFF), U6.14 (VDD14), U6.15 (VDD15), U6.16 (VDD16), U6.17 (VDD17), U6.18 (VDD18), U6.19 (VDD19), U6.20 (VDD20), U6.21 (VDD21), U6.22 (VDD22), U6.23 (VDD23), U6.24 (VDD24), U6.25 (VDD25), U6.26 (VDD26), U6.27 (VDD27), U6.28 (VDD28), U6.29 (VDD29), U6.30 (VDD30), U6.31 (VDD31), U6.32 (VDD32), U6.33 (VDD33), U6.34 (VDD34), U6.35 (VDD35), U6.36 (VDD36), U6.37 (VDD37), U6.38 (VDD38), U6.39 (VDD39), U6.40 (VDD40), U6.41 (VDD41), U6.42 (VDD42), U6.43 (VDD43), U6.44 (VDD44), U6.45 (VDD45), U6.46 (VDD46), U6.47 (VDD47), U6.48 (VDD48)
1.8V: C8.1, CF1.8-1.1, Q1.1 (G), U2.5 (OUT), U4.4 (IOVDD), U6.4 (IOVDD)
3.3V: C9.1, C10.1, R4.2, U3.2 (OUT), U5.1 (VDD), U5.4 (RST#), U5.17 (VUSB), U51.1 (VDD), U51.4 (RST#), U51.17 (VUSB)
GND: C1.1, C2.2, C3.2, C4.2, C5.2, C6.2, C7.2, C8.2, C9.2, C10.2, C11.2, C12.2, C13.2, C14.2, C15.2, C21.2, C22.2, C23.2, C24.2, C25.2, CF1.2, CF1.8-1.2, CN1.5 (GND), D1.2 (K), R3.1, R6.1, R9.1, R11.2, R13.2, U1.1 (PGND), U1.3 (AGND), U1.9 (GNDPAD), U2.2 (GND), U2.4 (NC), U3.1 (GND), U4.1 (CMQ), U4.2 (CMPLUS), U4.3 (CMMINUS), U4.12 (INCLK), U4.49 (GND), U5.20 (GND), U6.1 (CMQ), U6.2 (CMPLUS), U6.3 (CMMINUS), U6.12 (INCLK), U6.49 (GND), U51.20 (GND), X1.2 (GND)
INMISO: Q1.2 (S), U4.9 (INMISO)
INMOSI: R8.2, R9.2, U4.10 (INMOSI)
INSCK: R5.1, R6.2, U4.11 (INSCK)
LED: R12.2, U5.5 (GP0), U51.5 (GP0)
MISO: Q1.3 (D), R4.1, U5.13 (MISO), U51.13 (MISO)
MOSI: R8.1, U5.9 (MOSI), U51.9 (MOSI)
unnamed: C7.1, R1.1
unnamed: CN1.1 (5V), L1.1
unnamed: D1.1 (A), R12.1
unnamed: L2.1, U1.7 (SW), U1.8 (SW)
unnamed: R1.2, U1.5 (COMP)
unnamed: R2.2, R3.2, U1.4 (FB)
unnamed: R11.1, U4.5 (OUTCLK)
unnamed: R13.1, U6.5 (OUTCLK)
unnamed: R14.2, U6.9 (INMISO)
unnamed: R15.2, U6.10 (INMOSI)
unnamed: R16.2, U6.11 (INSCK)
OMISO2: P3.1, U6.8 (OUTMISO)
OMOSI2: P2.1, U6.7 (OUTMOSI)
OSC1: U5.2 (OSC1), U51.2 (OSC1), X1.1
OSC2: U5.3 (OSC2), U51.3 (OSC2), X1.3
OSCK2: P1.1, U6.6 (OUTSCK)
OUTMISO1: R14.1, U4.8 (OUTMISO)
OUTMOSI1: R15.1, U4.7 (OUTMOSI)
OUTSCK1: R16.1, U4.6 (OUTSCK)
SCK: R7.2, U5.11 (SCK), U51.11 (SCK)
SCK_OVR: R5.2, R7.1, U5.12 (GP5), U51.12 (GP5)
USB_5V: C1.2, C2.1, C3.1, CF1.1, L1.2, U1.2 (VIN), U2.1 (IN), U3.3 (IN)
USB_DM: CN1.2 (D-), U5.18 (USB_DM), U51.18 (USB_DM)
USB_DP: CN1.3 (D+), U5.19 (USB_DP), U51.19 (USB_DP)
V_EN: U1.6 (EN), U2.3 (EN), U5.14 (GP6), U51.14 (GP6)

Notes on the sheet:
R2= 24 -> 0.808V R2=100 -> 0.833V R2=180 -> 0.860V Vout=((R2+R3)/R3)*0.8
Notes: * All components should be rated 105C or above
