nanofury/NanoFury/NF1/kicad/NF6-MCP-V01/NF6-v01-ASICS-012.sch

## KiCad design NF1/kicad/NF6-MCP-V01/NF6-v01-ASICS-012.sch (2021-02-23, an earlier design)

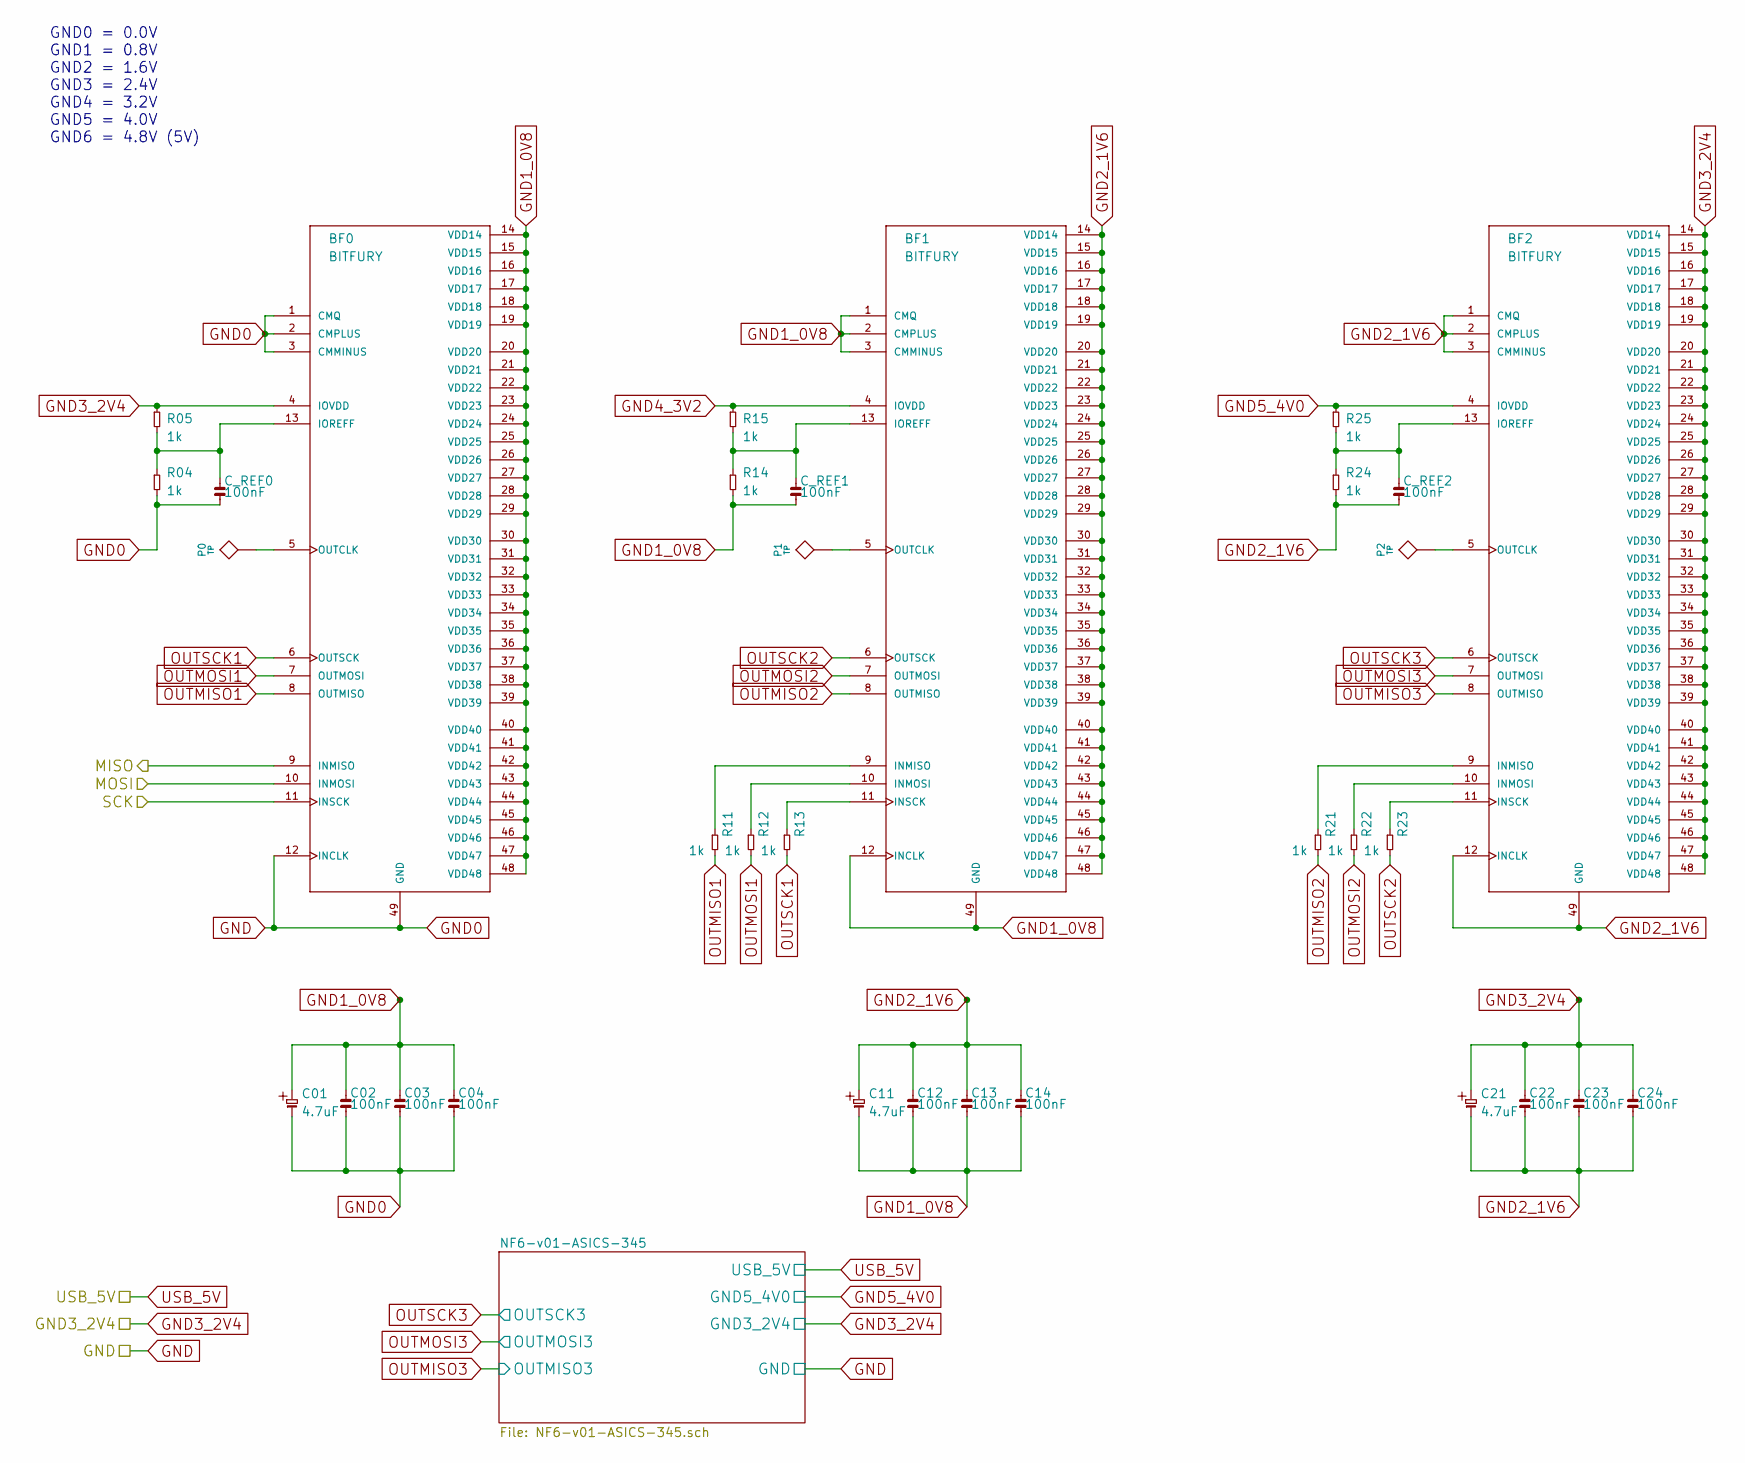
[picture p7: schematic NF6-v01-ASICS-012.sch]

Parts:
BF0, BF1, BF2: BITFURY; QFN48
C01, C11, C21: 4.7uF; 0805
C02, C03, C04, C12, C13, C14, C22, C23, C24: 100nF; 0603
C_REF0, C_REF1, C_REF2: 100nF; 0603
P0, P1, P2: TP
R04, R05, R11, R12, R13, R14, R15, R21, R22, R23, R24, R25: 1k; 0603

Connections:
GND: BF0.1 (CMQ), BF0.2 (CMPLUS), BF0.3 (CMMINUS), BF0.12 (INCLK), BF0.49 (GND), C01.2, C02.2, C03.2, C04.2, C_REF0.2, R04.1
GND1_0V8: BF0.14 (VDD14), BF0.15 (VDD15), BF0.16 (VDD16), BF0.17 (VDD17), BF0.18 (VDD18), BF0.19 (VDD19), BF0.20 (VDD20), BF0.21 (VDD21), BF0.22 (VDD22), BF0.23 (VDD23), BF0.24 (VDD24), BF0.25 (VDD25), BF0.26 (VDD26), BF0.27 (VDD27), BF0.28 (VDD28), BF0.29 (VDD29), BF0.30 (VDD30), BF0.31 (VDD31), BF0.32 (VDD32), BF0.33 (VDD33), BF0.34 (VDD34), BF0.35 (VDD35), BF0.36 (VDD36), BF0.37 (VDD37), BF0.38 (VDD38), BF0.39 (VDD39), BF0.40 (VDD40), BF0.41 (VDD41), BF0.42 (VDD42), BF0.43 (VDD43), BF0.44 (VDD44), BF0.45 (VDD45), BF0.46 (VDD46), BF0.47 (VDD47), BF0.48 (VDD48), BF1.1 (CMQ), BF1.2 (CMPLUS), BF1.3 (CMMINUS), BF1.12 (INCLK), BF1.49 (GND), C01.1, C02.1, C03.1, C04.1, C11.2, C12.2, C13.2, C14.2, C_REF1.2, R14.1
GND2_1V6: BF1.14 (VDD14), BF1.15 (VDD15), BF1.16 (VDD16), BF1.17 (VDD17), BF1.18 (VDD18), BF1.19 (VDD19), BF1.20 (VDD20), BF1.21 (VDD21), BF1.22 (VDD22), BF1.23 (VDD23), BF1.24 (VDD24), BF1.25 (VDD25), BF1.26 (VDD26), BF1.27 (VDD27), BF1.28 (VDD28), BF1.29 (VDD29), BF1.30 (VDD30), BF1.31 (VDD31), BF1.32 (VDD32), BF1.33 (VDD33), BF1.34 (VDD34), BF1.35 (VDD35), BF1.36 (VDD36), BF1.37 (VDD37), BF1.38 (VDD38), BF1.39 (VDD39), BF1.40 (VDD40), BF1.41 (VDD41), BF1.42 (VDD42), BF1.43 (VDD43), BF1.44 (VDD44), BF1.45 (VDD45), BF1.46 (VDD46), BF1.47 (VDD47), BF1.48 (VDD48), BF2.1 (CMQ), BF2.2 (CMPLUS), BF2.3 (CMMINUS), BF2.12 (INCLK), BF2.49 (GND), C11.1, C12.1, C13.1, C14.1, C21.2, C22.2, C23.2, C24.2, C_REF2.2, R24.1
GND3_2V4: BF0.4 (IOVDD), BF2.14 (VDD14), BF2.15 (VDD15), BF2.16 (VDD16), BF2.17 (VDD17), BF2.18 (VDD18), BF2.19 (VDD19), BF2.20 (VDD20), BF2.21 (VDD21), BF2.22 (VDD22), BF2.23 (VDD23), BF2.24 (VDD24), BF2.25 (VDD25), BF2.26 (VDD26), BF2.27 (VDD27), BF2.28 (VDD28), BF2.29 (VDD29), BF2.30 (VDD30), BF2.31 (VDD31), BF2.32 (VDD32), BF2.33 (VDD33), BF2.34 (VDD34), BF2.35 (VDD35), BF2.36 (VDD36), BF2.37 (VDD37), BF2.38 (VDD38), BF2.39 (VDD39), BF2.40 (VDD40), BF2.41 (VDD41), BF2.42 (VDD42), BF2.43 (VDD43), BF2.44 (VDD44), BF2.45 (VDD45), BF2.46 (VDD46), BF2.47 (VDD47), BF2.48 (VDD48), C21.1, C22.1, C23.1, C24.1, R05.2
GND4_3V2: BF1.4 (IOVDD), R15.2
GND5_4V0: BF2.4 (IOVDD), R25.2
MISO: BF0.9 (INMISO)
MOSI: BF0.10 (INMOSI)
unnamed: BF0.5 (OUTCLK), P0.1
unnamed: BF0.13 (IOREFF), C_REF0.1, R04.2, R05.1
unnamed: BF1.5 (OUTCLK), P1.1
unnamed: BF1.9 (INMISO), R11.2
unnamed: BF1.10 (INMOSI), R12.2
unnamed: BF1.11 (INSCK), R13.2
unnamed: BF1.13 (IOREFF), C_REF1.1, R14.2, R15.1
unnamed: BF2.5 (OUTCLK), P2.1
unnamed: BF2.9 (INMISO), R21.2
unnamed: BF2.10 (INMOSI), R22.2
unnamed: BF2.11 (INSCK), R23.2
unnamed: BF2.13 (IOREFF), C_REF2.1, R24.2, R25.1
OUTMISO1: BF0.8 (OUTMISO), R11.1
OUTMISO2: BF1.8 (OUTMISO), R21.1
OUTMISO3: BF2.8 (OUTMISO)
OUTMOSI1: BF0.7 (OUTMOSI), R12.1
OUTMOSI2: BF1.7 (OUTMOSI), R22.1
OUTMOSI3: BF2.7 (OUTMOSI)
OUTSCK1: BF0.6 (OUTSCK), R13.1
OUTSCK2: BF1.6 (OUTSCK), R23.1
OUTSCK3: BF2.6 (OUTSCK)
SCK: BF0.11 (INSCK)

Notes on the sheet:
GND0 = 0.0V GND1 = 0.8V GND2 = 1.6V GND3 = 2.4V GND4 = 3.2V GND5 = 4.0V GND6 = 4.8V (5V)
