nanofury/NanoFury/NF1/kicad/NF6-MCP-V01/NF6-v01-ASICS-345.sch

## KiCad design NF1/kicad/NF6-MCP-V01/NF6-v01-ASICS-345.sch (2021-02-23, an earlier design)

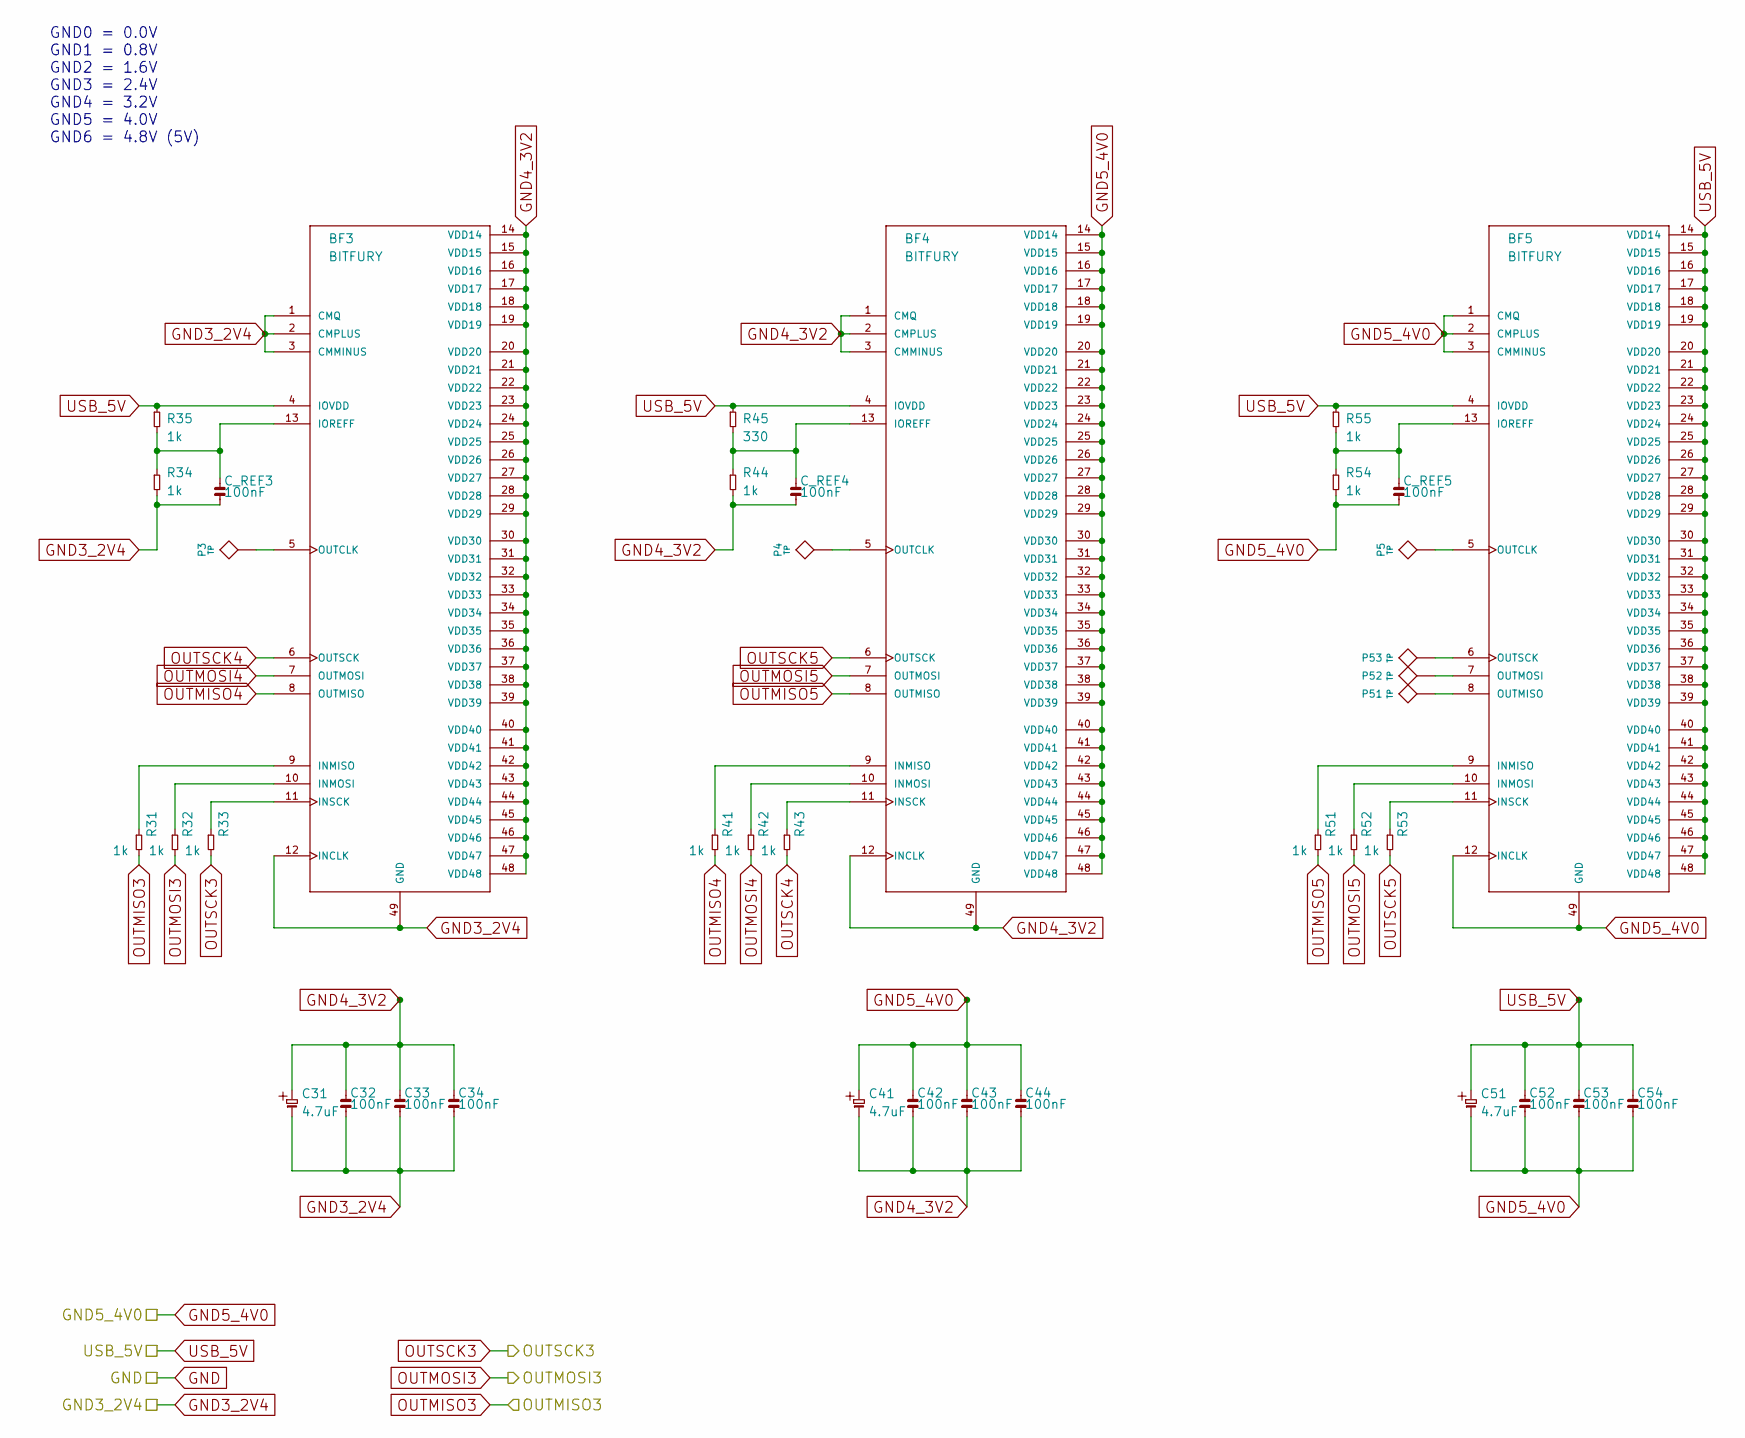
[picture p8: schematic NF6-v01-ASICS-345.sch]

Parts:
BF3, BF4, BF5: BITFURY; QFN48
C31, C41, C51: 4.7uF; 0805
C32, C33, C34, C42, C43, C44, C52, C53, C54: 100nF; 0603
C_REF3, C_REF4, C_REF5: 100nF; 0603
P3, P4, P5, P51, P52, P53: TP
R31, R32, R33, R34, R35, R41, R42, R43, R44, R51, R52, R53, R54, R55: 1k; 0603
R45: 330; 0603

Connections:
GND3_2V4: BF3.1 (CMQ), BF3.2 (CMPLUS), BF3.3 (CMMINUS), BF3.12 (INCLK), BF3.49 (GND), C31.2, C32.2, C33.2, C34.2, C_REF3.2, R34.1
GND4_3V2: BF3.14 (VDD14), BF3.15 (VDD15), BF3.16 (VDD16), BF3.17 (VDD17), BF3.18 (VDD18), BF3.19 (VDD19), BF3.20 (VDD20), BF3.21 (VDD21), BF3.22 (VDD22), BF3.23 (VDD23), BF3.24 (VDD24), BF3.25 (VDD25), BF3.26 (VDD26), BF3.27 (VDD27), BF3.28 (VDD28), BF3.29 (VDD29), BF3.30 (VDD30), BF3.31 (VDD31), BF3.32 (VDD32), BF3.33 (VDD33), BF3.34 (VDD34), BF3.35 (VDD35), BF3.36 (VDD36), BF3.37 (VDD37), BF3.38 (VDD38), BF3.39 (VDD39), BF3.40 (VDD40), BF3.41 (VDD41), BF3.42 (VDD42), BF3.43 (VDD43), BF3.44 (VDD44), BF3.45 (VDD45), BF3.46 (VDD46), BF3.47 (VDD47), BF3.48 (VDD48), BF4.1 (CMQ), BF4.2 (CMPLUS), BF4.3 (CMMINUS), BF4.12 (INCLK), BF4.49 (GND), C31.1, C32.1, C33.1, C34.1, C41.2, C42.2, C43.2, C44.2, C_REF4.2, R44.1
GND5_4V0: BF4.14 (VDD14), BF4.15 (VDD15), BF4.16 (VDD16), BF4.17 (VDD17), BF4.18 (VDD18), BF4.19 (VDD19), BF4.20 (VDD20), BF4.21 (VDD21), BF4.22 (VDD22), BF4.23 (VDD23), BF4.24 (VDD24), BF4.25 (VDD25), BF4.26 (VDD26), BF4.27 (VDD27), BF4.28 (VDD28), BF4.29 (VDD29), BF4.30 (VDD30), BF4.31 (VDD31), BF4.32 (VDD32), BF4.33 (VDD33), BF4.34 (VDD34), BF4.35 (VDD35), BF4.36 (VDD36), BF4.37 (VDD37), BF4.38 (VDD38), BF4.39 (VDD39), BF4.40 (VDD40), BF4.41 (VDD41), BF4.42 (VDD42), BF4.43 (VDD43), BF4.44 (VDD44), BF4.45 (VDD45), BF4.46 (VDD46), BF4.47 (VDD47), BF4.48 (VDD48), BF5.1 (CMQ), BF5.2 (CMPLUS), BF5.3 (CMMINUS), BF5.12 (INCLK), BF5.49 (GND), C41.1, C42.1, C43.1, C44.1, C51.2, C52.2, C53.2, C54.2, C_REF5.2, R54.1
unnamed: BF3.5 (OUTCLK), P3.1
unnamed: BF3.9 (INMISO), R31.2
unnamed: BF3.10 (INMOSI), R32.2
unnamed: BF3.11 (INSCK), R33.2
unnamed: BF3.13 (IOREFF), C_REF3.1, R34.2, R35.1
unnamed: BF4.5 (OUTCLK), P4.1
unnamed: BF4.9 (INMISO), R41.2
unnamed: BF4.10 (INMOSI), R42.2
unnamed: BF4.11 (INSCK), R43.2
unnamed: BF4.13 (IOREFF), C_REF4.1, R44.2, R45.1
unnamed: BF5.5 (OUTCLK), P5.1
unnamed: BF5.6 (OUTSCK), P53.1
unnamed: BF5.7 (OUTMOSI), P52.1
unnamed: BF5.8 (OUTMISO), P51.1
unnamed: BF5.9 (INMISO), R51.2
unnamed: BF5.10 (INMOSI), R52.2
unnamed: BF5.11 (INSCK), R53.2
unnamed: BF5.13 (IOREFF), C_REF5.1, R54.2, R55.1
OUTMISO3: R31.1
OUTMISO4: BF3.8 (OUTMISO), R41.1
OUTMISO5: BF4.8 (OUTMISO), R51.1
OUTMOSI3: R32.1
OUTMOSI4: BF3.7 (OUTMOSI), R42.1
OUTMOSI5: BF4.7 (OUTMOSI), R52.1
OUTSCK3: R33.1
OUTSCK4: BF3.6 (OUTSCK), R43.1
OUTSCK5: BF4.6 (OUTSCK), R53.1
USB_5V: BF3.4 (IOVDD), BF4.4 (IOVDD), BF5.4 (IOVDD), BF5.14 (VDD14), BF5.15 (VDD15), BF5.16 (VDD16), BF5.17 (VDD17), BF5.18 (VDD18), BF5.19 (VDD19), BF5.20 (VDD20), BF5.21 (VDD21), BF5.22 (VDD22), BF5.23 (VDD23), BF5.24 (VDD24), BF5.25 (VDD25), BF5.26 (VDD26), BF5.27 (VDD27), BF5.28 (VDD28), BF5.29 (VDD29), BF5.30 (VDD30), BF5.31 (VDD31), BF5.32 (VDD32), BF5.33 (VDD33), BF5.34 (VDD34), BF5.35 (VDD35), BF5.36 (VDD36), BF5.37 (VDD37), BF5.38 (VDD38), BF5.39 (VDD39), BF5.40 (VDD40), BF5.41 (VDD41), BF5.42 (VDD42), BF5.43 (VDD43), BF5.44 (VDD44), BF5.45 (VDD45), BF5.46 (VDD46), BF5.47 (VDD47), BF5.48 (VDD48), C51.1, C52.1, C53.1, C54.1, R35.2, R45.2, R55.2

Notes on the sheet:
GND0 = 0.0V GND1 = 0.8V GND2 = 1.6V GND3 = 2.4V GND4 = 3.2V GND5 = 4.0V GND6 = 4.8V (5V)
