nanofury/NanoFury/NF1/kicad/NF6-MCP-V02/NF6-MCP2210-v02.sch

## KiCad design NF1/kicad/NF6-MCP-V02/NF6-MCP2210-v02.sch (2021-02-23, an earlier design)

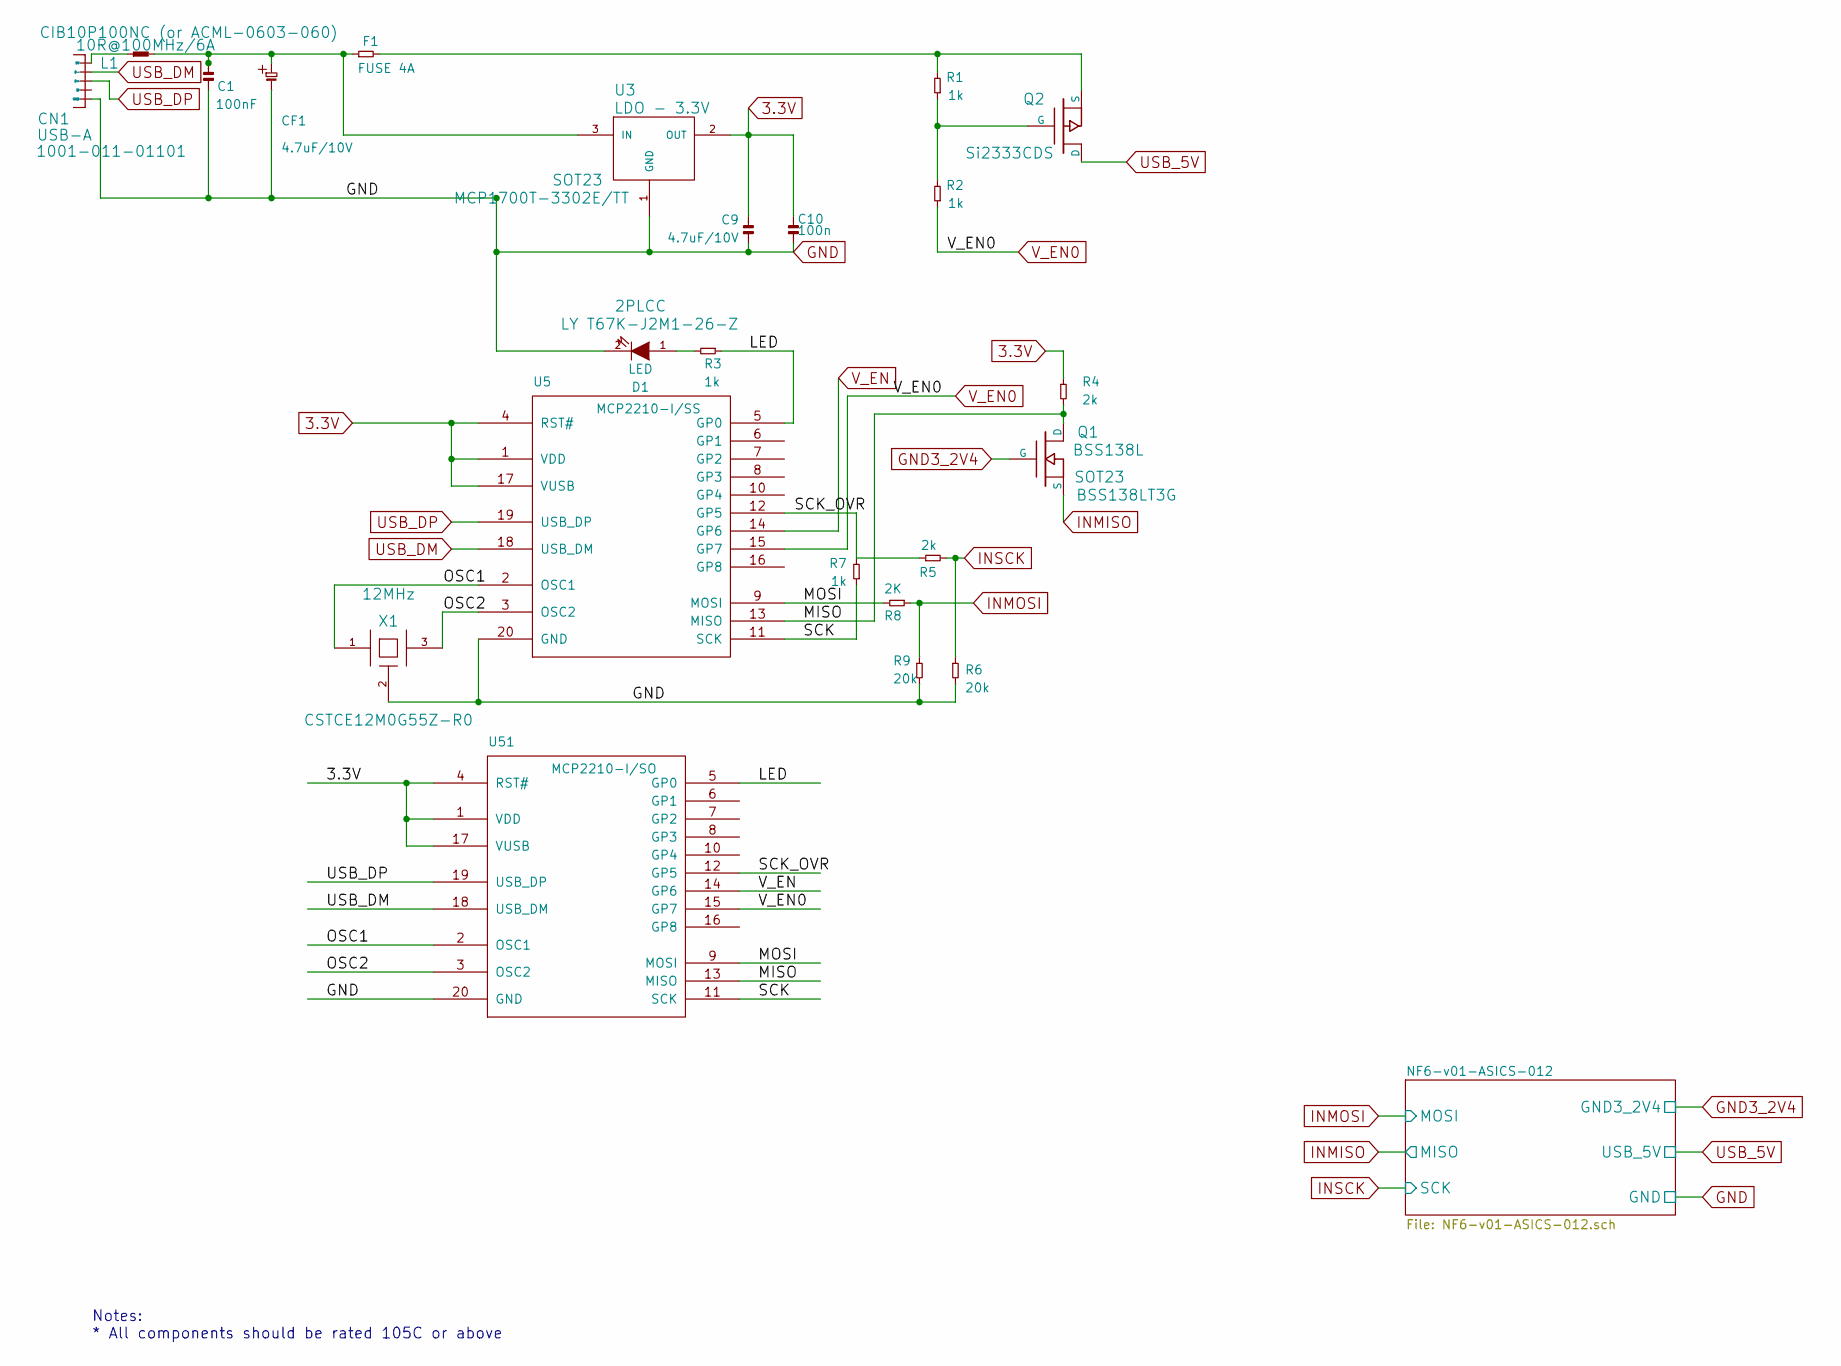
[picture p9: schematic NF6-MCP2210-v02.sch]

Parts:
C1: 100nF; 0603
C9: 4.7uF/10V; 0805
C10: 100n; 0603
CF1: 4.7uF/10V; 0805
CN1: USB-A; CNC-1001-011-01101
D1: LED; 2PLCC
F1: FUSE 4A; 0603
L1: 10R@100MHz/6A; 0603
Q1: BSS138L; SOT23; Manufacturer Part Number BSS138LT3G
Q2: Si2333CDS; SOT23
R1, R2, R3, R7: 1k; 0603
R4: 2k; 0603
R5: 2k; 0805
R6, R9: 20k; 0603
R8: 2K; 0603
U3: LDO - 3.3V; SOT23
U5: MCP2210-I/SS; SSOP-20
U51: MCP2210-I/SO; SOIC20
X1: 12MHz; CSTCE_G15C

Connections:
3.3V: C9.1, C10.1, R4.2, U3.2 (OUT), U5.1 (VDD), U5.4 (RST#), U5.17 (VUSB), U51.1 (VDD), U51.4 (RST#), U51.17 (VUSB)
GND: C1.1, C9.2, C10.2, CF1.2, CN1.5 (GND), D1.2 (K), R6.1, R9.1, U3.1 (GND), U5.20 (GND), U51.20 (GND), X1.2 (GND)
GND3_2V4: Q1.1 (G)
INMISO: Q1.2 (S)
INMOSI: R8.2, R9.2
INSCK: R5.1, R6.2
LED: R3.2, U5.5 (GP0), U51.5 (GP0)
MISO: Q1.3 (D), R4.1, U5.13 (MISO), U51.13 (MISO)
MOSI: R8.1, U5.9 (MOSI), U51.9 (MOSI)
unnamed: C1.2, CF1.1, F1.2, L1.2, U3.3 (IN)
unnamed: CN1.1 (5V), L1.1
unnamed: D1.1 (A), R3.1
unnamed: F1.1, Q2.2 (S), R1.1
unnamed: Q2.1 (G), R1.2, R2.1
OSC1: U5.2 (OSC1), U51.2 (OSC1), X1.1
OSC2: U5.3 (OSC2), U51.3 (OSC2), X1.3
SCK: R7.2, U5.11 (SCK), U51.11 (SCK)
SCK_OVR: R5.2, R7.1, U5.12 (GP5), U51.12 (GP5)
USB_5V: Q2.3 (D)
USB_DM: CN1.2 (D-), U5.18 (USB_DM), U51.18 (USB_DM)
USB_DP: CN1.3 (D+), U5.19 (USB_DP), U51.19 (USB_DP)
V_EN: U5.14 (GP6), U51.14 (GP6)
V_EN0: R2.2, U5.15 (GP7), U51.15 (GP7)

Notes on the sheet:
Notes: * All components should be rated 105C or above
